rosstimo/MotorProject/README.md

# MotorProject
Super Fantastic Motor Project
