rosstimo/MotorProject/Documentation/LaTeX files/sections/MotorSpecifications.tex

\documentclass[main.tex]{subfiles}

\begin{document}

\section{Motor Manufacturer Specifications}

\subsection{RS-775126000E7 Motor}
PG27 RS775-125 Motor with Encoder

\noindent
The test motor was purchased here: \href{https://www.andymark.com/products/rs775-125-motor-with-encoder-for-pg27-gearbox}{www.andymark.com (PG27 RS775-125 Motor with Encoder)}

    \begin{figure}[h]
        %\centering  
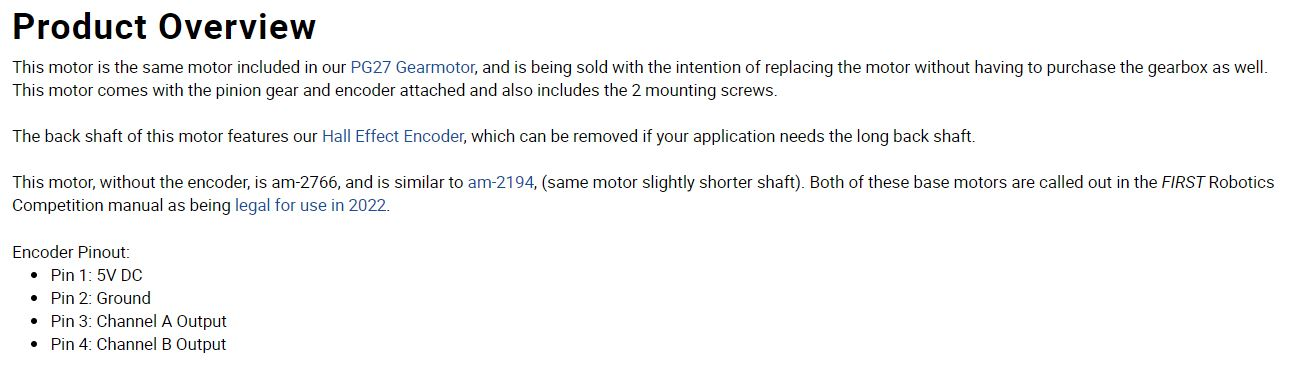
[picture p12: Documentation/LaTeX files/images/IMG_MotorRS_Overview.jpg]
        
        \vspace{0pt}
        %\caption{RS-775126000E7 Overview} %\label{Fig:BluetoothSpeaker}
    \end{figure}
\vspace{-30pt}
    \begin{figure}[h]
        %\centering  
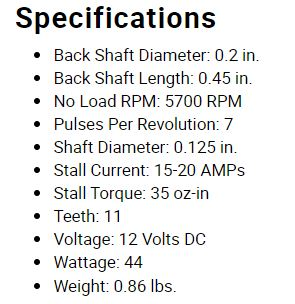
[picture p13: Documentation/LaTeX files/images/IMG_MotorRS_Specifications.jpg]
        
        \vspace{0pt}
        %\caption{RS-775126000E7 Overview} %\label{Fig:BluetoothSpeaker}
    \end{figure}

    \begin{figure}[h]
        \centering  
        
        \vspace{0pt}
        \caption{RS-775126000E7 Dimensions} %\label{Fig:BluetoothSpeaker}
    \end{figure}

    \noindent Motor dimensions pdf can be downloaded here: \href{https://cdn.andymark.com/media/W1siZiIsIjIwMjAvMDEvMDIvMTYvMzkvMzYvMjE2ZDkxMjgtMGY5OC00ZTFjLWJiNjItODU5YmVmY2I2OTcxL2FtLTMxMDkgUlM3NzUtMTI1IE1vdG9yIHdpdGggRW5jb2Rlci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}{andymark.com (layout prints PG27 RS775-125 Motor with Encoder)}

\clearpage
    \subsection{TS-25GA370H-20 Motor}
    Encoder Metal Gearmotor 12V DC High Speed 300RPM Gear Motor with Encoder for Arduino and 3D Printers\\

    \noindent The test motor was purchased here: \href{https://www.amazon.com/Bemonoc-Encoder-Gearmotor-Two-Channel-Effect/dp/B07GNGCNK1?th=1}{www.amazon.com (Encoder Metal Gearmotor 12V DC High Speed 300RPM Gear Motor with Encoder for Arduino and 3D Printers)}

    \noindent \textbf{Product type}: DC Gear motor with two-channel Hall effect encoder
    \begin{itemize}
        \item Rated Voltage: 12V
        \item No-Load Speed: 300RPM
        \item No-Load Current: $\leq$ 0.15A
        \item Rated Torque: 0.5kg.cm
        \item Single Output 240 Pulses Per Revolution
        \item Gear Reduction Ratio: 1/20
        \item Each Loop Output Pulses: 12PPR 20$\times$12=240PPR
    \end{itemize}

    %\begin{figure}[h]
    %    \centering  
    %    \includegraphics[width=0.6\textwidth]{images/IMG_MotorTS_Specifications.jpg}
    %    \vspace{0pt}
    %    \caption{TS-25GA370H-20 Motor Specifications} %\label{Fig:BluetoothSpeaker}
    %\end{figure}

    \begin{figure}[h]
        \centering  
        
        \vspace{0pt}
        \caption{TS-25GA370H-20 Wiring} %\label{Fig:BluetoothSpeaker}
    \end{figure}

    \noindent \textbf{Motor Dimensions}:
    \begin{itemize}
        \item Main Body: 66 x 25mm / 2.6in x 0.99in (L*D)
        \item Out Shaft: 11 x 4mm / 0.433 x 0.1575in (L*D) with 10 x 0.5mm / 0.39 * 0.017inches flat cut off
    \end{itemize}
    
    \begin{figure}[h]
        \centering  
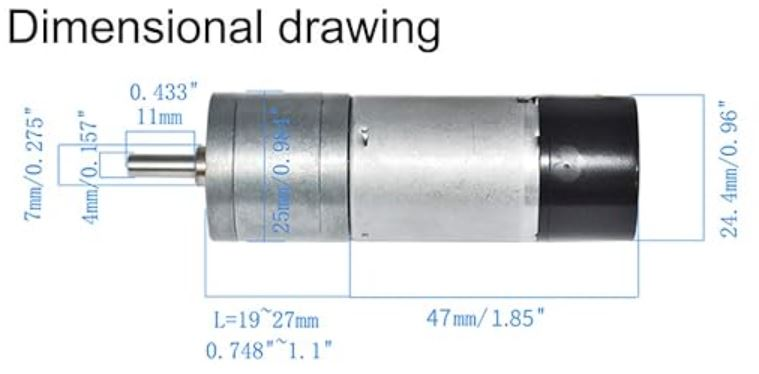
[picture p14: Documentation/LaTeX files/images/IMG_MotorTS_Dimensions.jpg]
        
        \vspace{0pt}
        \caption{TS-25GA370H-20 Dimensions} %\label{Fig:BluetoothSpeaker}
    \end{figure}

\end{document}
