rosstimo/MotorProject/Documentation/LaTeX files/main.tex

\documentclass[a4paper,10pt]{article}

\usepackage{fancyhdr}
\usepackage{graphicx}
\usepackage{float}
\usepackage{geometry}
\geometry{a4paper, left=2cm, right=2cm, top=1.5cm, bottom=3cm }
\usepackage{caption}
\usepackage{subcaption}
\captionsetup[figure]{labelfont=bf}

%% Widow/orphan control
\raggedbottom
\widowpenalty=10000
\clubpenalty=10000
\usepackage{tabularx}
\usepackage{longtable}
\usepackage{siunitx}
\usepackage{hyperref}
    \hypersetup{
        colorlinks=true,
        linkcolor={black!50!black},
        citecolor={blue!50!black},
        urlcolor=blue, %{blue!80!blue}
        }

\urlstyle{same}

\usepackage{pdfpages}

\fancypagestyle{pdfpagestyle}{
  \fancyhf{}
  \rfoot{\thepage}
  \renewcommand{\headrulewidth}{0pt}
  \renewcommand{\footrulewidth}{0pt}
}

\usepackage{natbib}
\usepackage[dvipsnames]{xcolor}
\usepackage{subfiles}

\definecolor{roarange_lt}{RGB}{246, 146, 64}
\usepackage{etoolbox,fancyhdr,xcolor}
\newcommand{\headrulecolor}[1]{\patchcmd{\headrule}{\hrule}{\color{#1}\hrule}{}{}}
\newcommand{\footrulecolor}[1]{\patchcmd{\footrule}{\hrule}{\color{#1}\hrule}{}{}}
\renewcommand{\headrulewidth}{1pt}
\headrulecolor{roarange_lt!100}%
\renewcommand{\footrulewidth}{1pt}
\footrulecolor{roarange_lt!100}%

\fancyhf{}
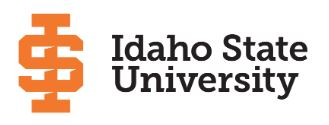
[picture p15: Documentation/LaTeX files/images/ISU_Logo.JPG]
\fancyhead[R]{}

\fancyfoot[L]{Project: PLC Lab Trainer System}
\fancyfoot[C]{College of Technology}
\fancyfoot[R]{\thepage}

\setlength{\headheight}{15mm}
\pagestyle{fancy}

\bibliographystyle{apalike}

\usepackage{times}
\begin{document}

%% ---- Cover Page ----
\begin{titlepage}
\centering

\vspace*{2cm}

\\[2cm]

{\color{roarange_lt}\rule{\textwidth}{2pt}}\\[0.6cm]

{\fontsize{28}{34}\selectfont \textbf{PLC LAB TRAINER SYSTEM}}\\[0.5cm]

{\fontsize{20}{24}\selectfont TECHNICAL MANUAL}\\[0.6cm]

{\color{roarange_lt}\rule{\textwidth}{2pt}}\\[1.2cm]

{\Large \textit{Heater Control Box \& Motor Control Box}}\\[3cm]

{\large \textbf{Authors}}\\[0.4cm]
{\large B. Anderson \quad T. Leishman \quad T. Rossiter}\\[2cm]

{\large Idaho State University}\\
{\large College of Technology}\\
{\large Pocatello, Idaho}\\[1cm]

{\large \today}

\vfill

\end{titlepage}

%% ---- Table of Contents ----
\tableofcontents
\clearpage

%% ---- Introduction / Project Overview ----
\subfile{sections/ProjectOverview}
\clearpage

%% ---- Part I: System Interfaces ----
\part{System Interfaces}
\subfile{sections/SystemArchitecture}
\clearpage

%% ---- Part II: Heater Control Box ----
\part{Heater Control Box}
\subfile{sections/HeaterBoxOverview}
\clearpage
\subfile{sections/HeaterBoxComponents}
\clearpage
\subfile{sections/HeaterBoxPLCInterface}
\clearpage

%% ---- Part III: Motor Control Box ----
\part{Motor Control Box}
\subfile{sections/Introduction}
\clearpage
\subfile{sections/MotorSpecsSummary}
\clearpage
\subfile{sections/SchematicDescription}
\clearpage
\section{Pico Encoder Documentation}
\subfile{sections/UsingQuadratureEncoderForMotorDirectionSpeedAndPosition}
\clearpage
\subfile{sections/EncoderImplementation}
\subfile{sections/EncoderFeedbackConfiguration}
\clearpage
\subfile{sections/PicoSetupGuide}

%% ---- Appendices ----
\clearpage
\appendix
\part*{Appendices}
\addcontentsline{toc}{part}{Appendices}

\section{Motor Characterization Test Data}
\label{app:motor_testing}
\subfile{sections/MotorSpecifications}
\clearpage
\subfile{sections/InitialTests}
\clearpage
\subfile{sections/EncoderTestingResults}
\clearpage

\section{Circuit Development History}
\label{app:circuit_dev}
\subfile{sections/HBridgeDevelopment}
\clearpage
\subfile{sections/TL494HBridgeDevelopment}
\clearpage

\subfile{sections/AppendixBOM}

\fontsize{8}{9}\selectfont
\bibliography{ResearchPaperBib}

\end{document}
