rosstimo/MotorProject/Documentation/LaTeX files/images/Current Design/Htr box Ain.png

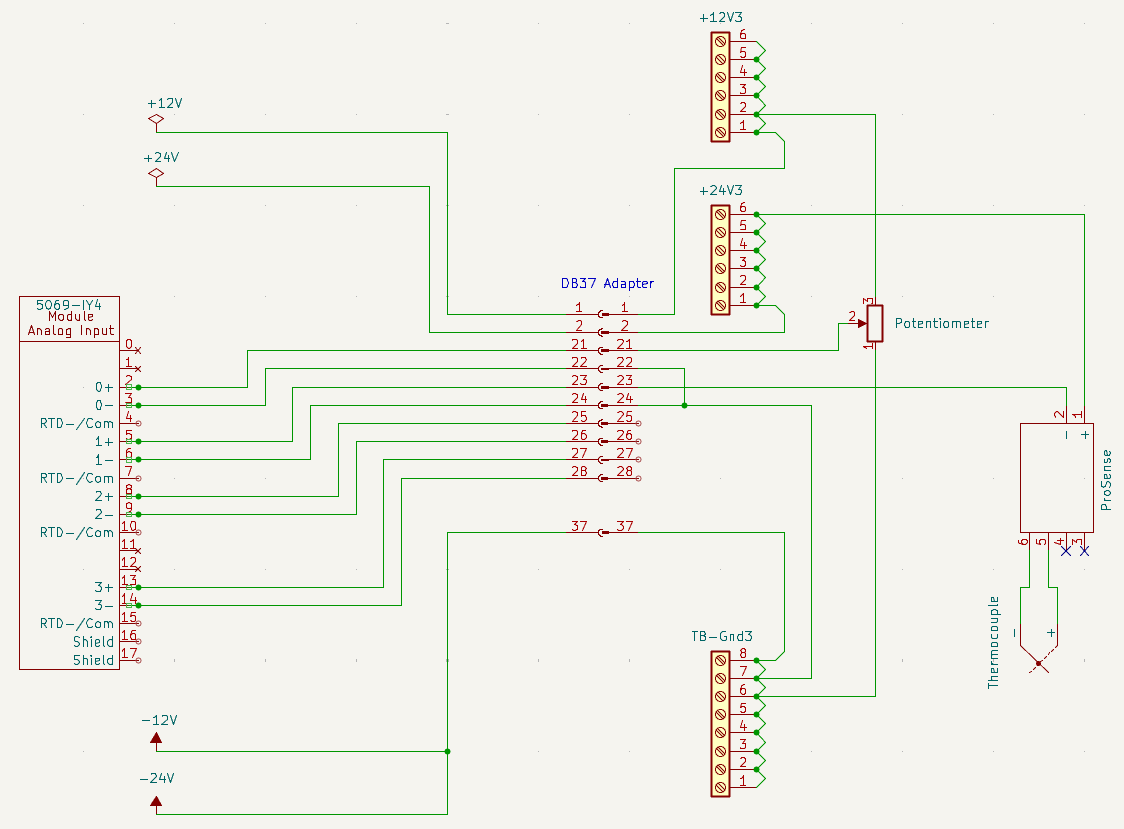
Documentation/LaTeX files/images/Current Design/Htr box Ain.png
