rosstimo/MotorProject/Documentation/LaTeX files/images/Current Design/Htr box Aout.png

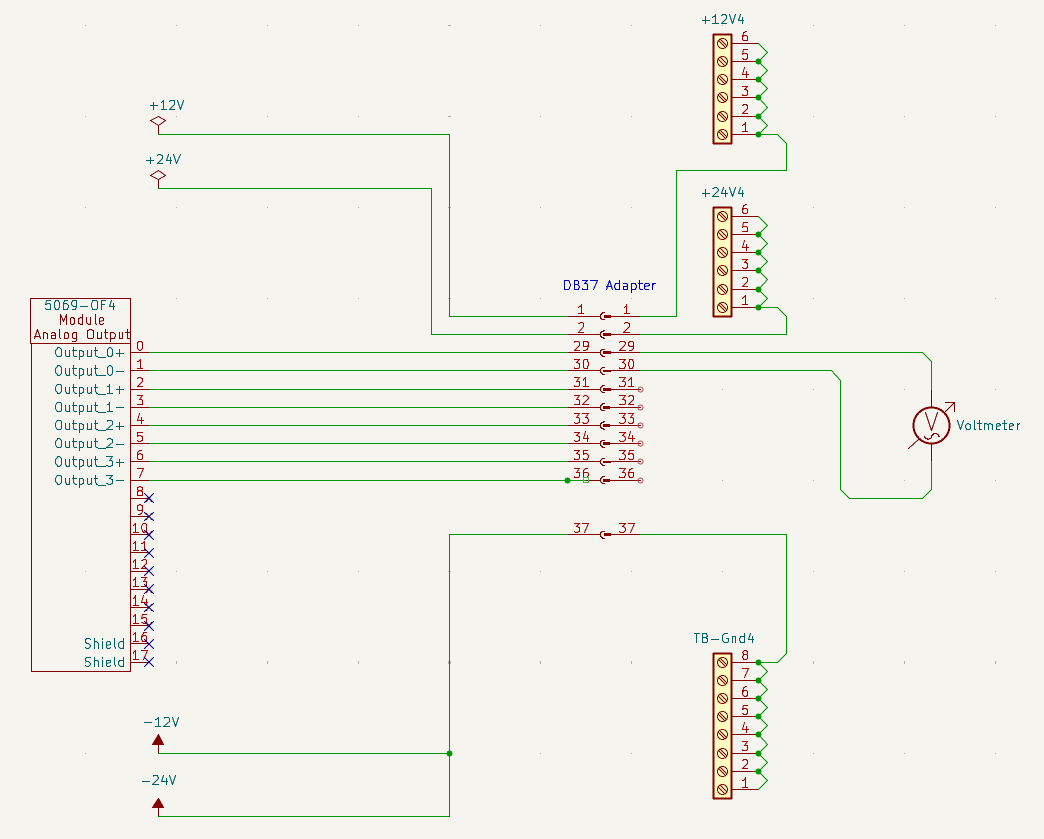
Documentation/LaTeX files/images/Current Design/Htr box Aout.png
