rosstimo/MotorProject/Documentation/LaTeX files/images/Current Design/Htr box Din.png

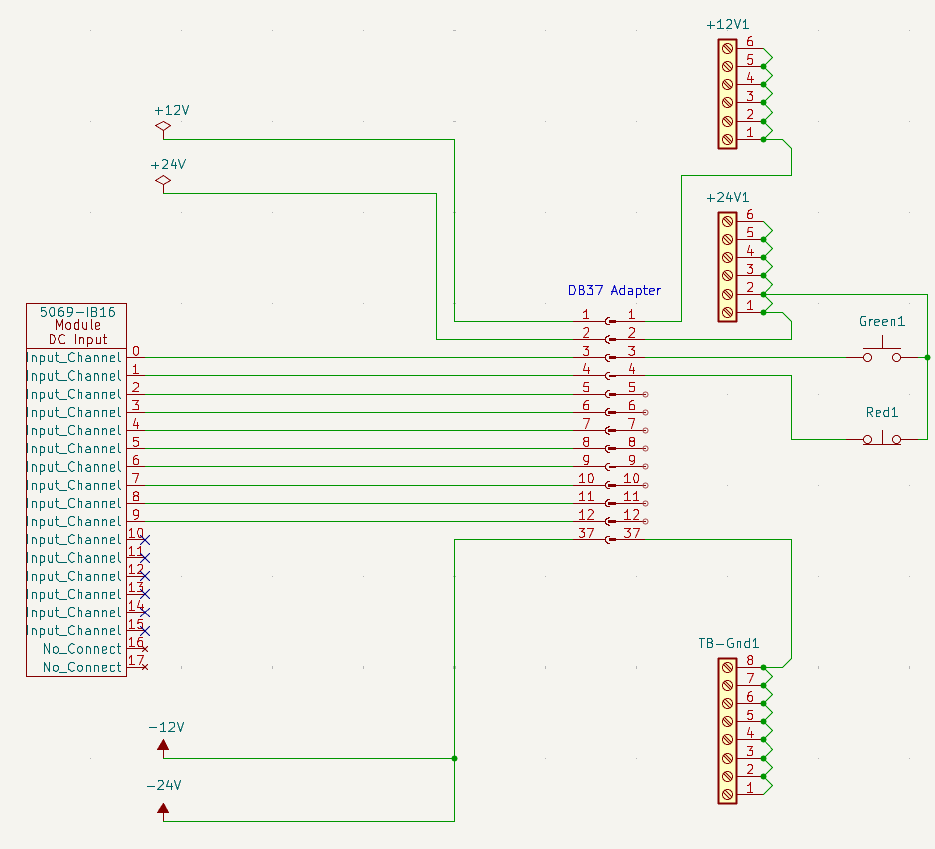
Documentation/LaTeX files/images/Current Design/Htr box Din.png
