rosstimo/MotorProject/Documentation/LaTeX files/images/Current Design/Htr box Dout.png

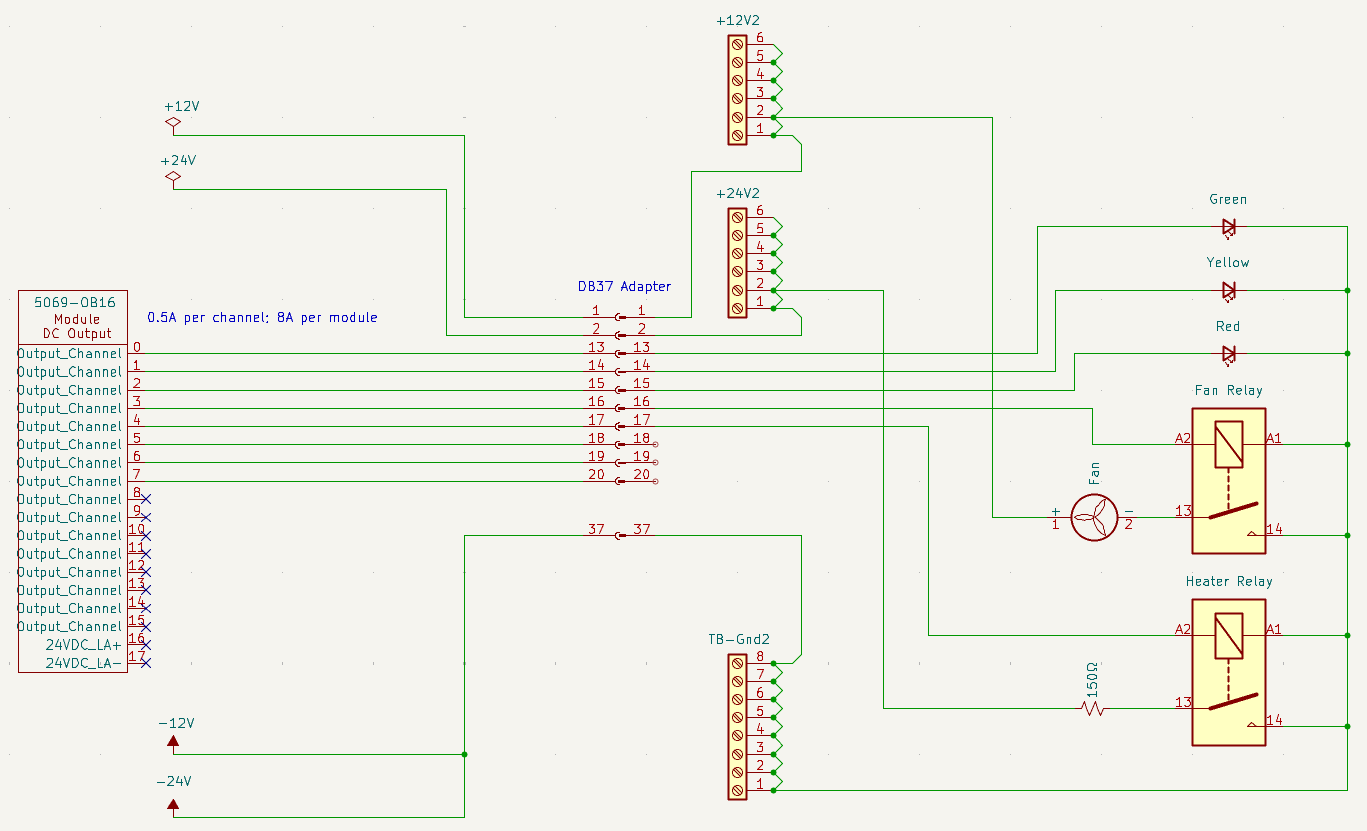
Documentation/LaTeX files/images/Current Design/Htr box Dout.png
