rosstimo/MotorProject/Documentation/LaTeX files/images/DB37 to Phoenix Contact TB.png

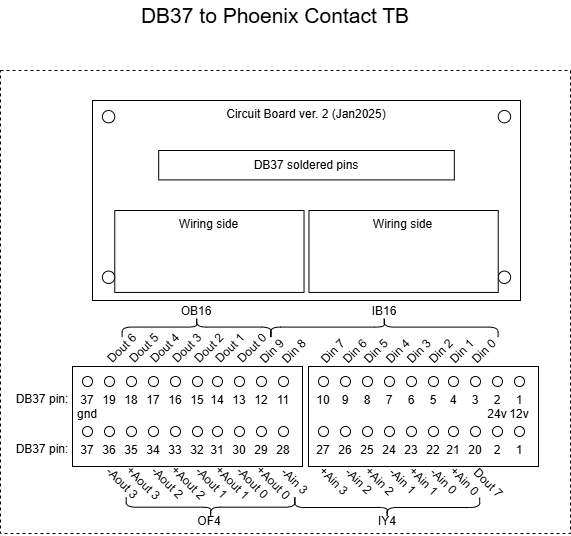
Documentation/LaTeX files/images/DB37 to Phoenix Contact TB.png
