rosstimo/MotorProject/Documentation/LaTeX files/images/Heater Box Schematic.png

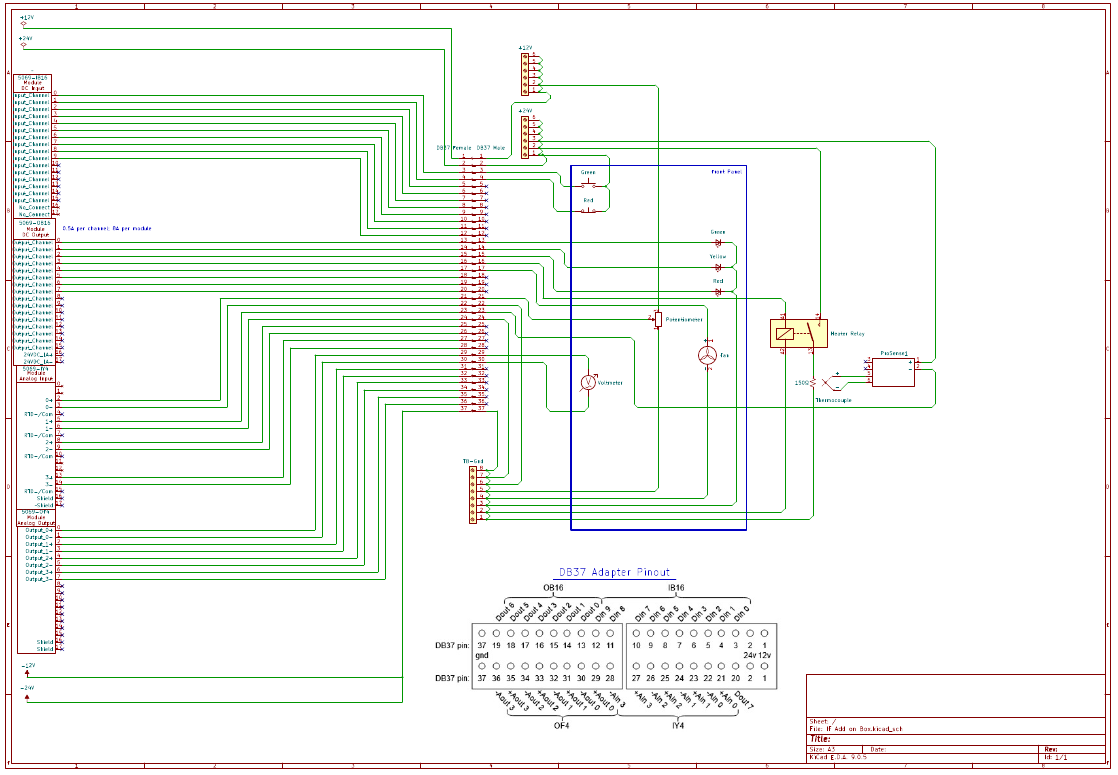
Documentation/LaTeX files/images/Heater Box Schematic.png
