rosstimo/MotorProject/Documentation/LaTeX files/images/IMG_MotorSpecificationsRS.jpg

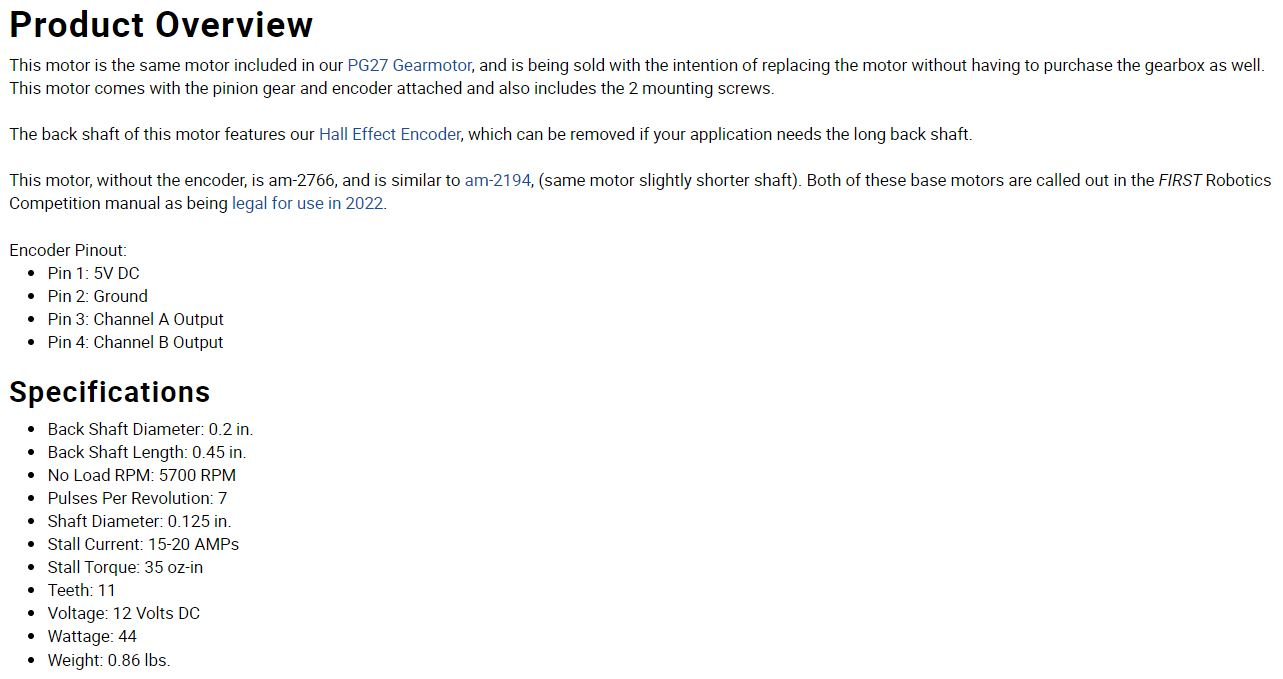
Documentation/LaTeX files/images/IMG_MotorSpecificationsRS.jpg
