rosstimo/MotorProject/Documentation/LaTeX files/images/IMG_MotorTS_Specifications.jpg

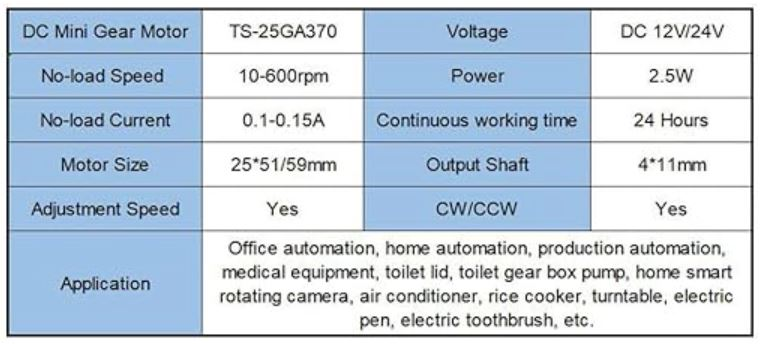
Documentation/LaTeX files/images/IMG_MotorTS_Specifications.jpg
