rosstimo/MotorProject/Mechanical/MotorDrawings/TS25GA370H_DimensionalDrawingAndSpecifications.JPG

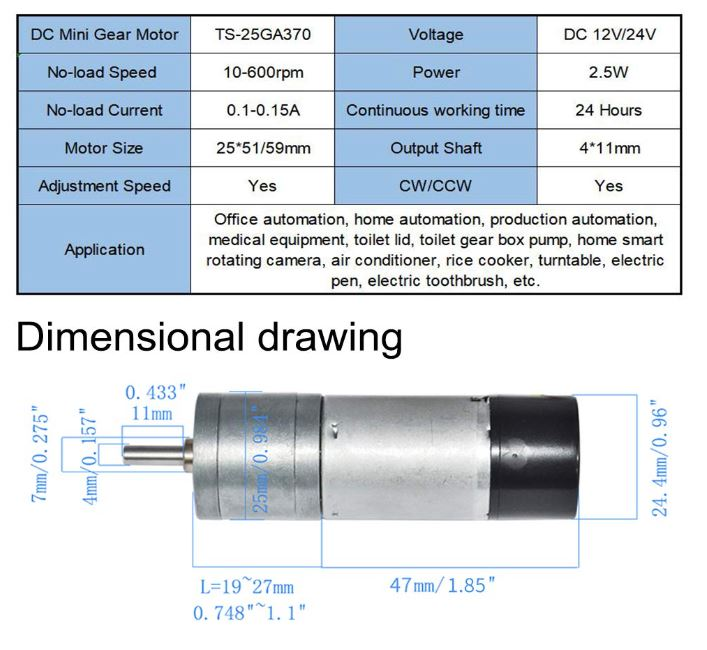
Mechanical/MotorDrawings/TS25GA370H_DimensionalDrawingAndSpecifications.JPG
