rosstimo/MotorProject/Documentation/LaTeX files/sections/AppendixBOM.tex

\documentclass[main.tex]{subfiles}

\begin{document}

\section{Bill of Materials}
\label{app:bom}

This appendix lists the BOMs for the PLC Lab Trainer System. The two trainer boxes share a common set of enclosure, cabling, and operator-interface parts (Section~\ref{sec:bom-common}); each box then adds its own subsystem-specific components (Sections~\ref{sec:bom-heater-specific} and~\ref{sec:bom-motor-specific}). Section~\ref{sec:bom-pico} lists the components on the Pico H-Bridge motor control board that mounts inside the Motor Control Box. Box-level quantities are listed per unit; the project deploys 16 of each box.

\subsection{Common Box Components}
\label{sec:bom-common}

Table~\ref{tab:bom-common} lists the components installed in both the Heater Control Box and the Motor Control Box. Each box receives one set of these parts.

\renewcommand{\arraystretch}{1.3}
\begin{longtable}{p{6.5cm} l l c}
\caption{Common Box Bill of Materials (per box, applies to both Heater and Motor boxes)} \label{tab:bom-common} \\
\hline
\textbf{Description} & \textbf{Mfg.\ Part \#} & \textbf{Source} & \textbf{Qty} \\
\hline
\endfirsthead
\hline
\textbf{Description} & \textbf{Mfg.\ Part \#} & \textbf{Source} & \textbf{Qty} \\
\hline
\endhead
\hline
\endfoot

\multicolumn{4}{l}{\textit{Enclosure and Cabling}} \\
\hline
Hinged outdoor junction box (enclosure) & ZH-121006 & PolyCase & 1 \\
DB37 male shielded cable, 1\,m & Phoenix 2926580 & Digikey & 1 \\
\hline

\multicolumn{4}{l}{\textit{Operator Interface}} \\
\hline
Potentiometer, 22\,mm panel mount, 4.7\,k\si{\ohm} & Schneider XB5AD912R4K7 & Grainger & 1 \\
Pushbutton, 22\,mm green, momentary 1NO & Dayton 30G225 & Grainger & 1 \\
Pushbutton, 22\,mm red, momentary 1NC & Dayton 30G230 & Grainger & 1 \\
Pilot light, 22\,mm green LED, 24\,V & Schneider 55WU15 & Grainger & 1 \\
Pilot light, 22\,mm yellow LED, 24\,V & Schneider 55WU17 & Grainger & 1 \\
Pilot light, 22\,mm red LED, 24\,V & Schneider 55WU16 & Grainger & 1 \\
\hline

\multicolumn{4}{l}{\textit{DB37 Passthrough Interface PCB}} \\
\hline
DB-37 male PCB-mount connector & Amphenol L717SDCH37POL2RM8C309 & Mouser & 1 \\
Terminal block, 20-position (2 rows of 10), 3.5\,mm pitch & Phoenix 1841571 (SPTD 1,5/10-H-3,5) & Mouser & 2 \\
Terminal block, 10-position (2 rows of 5), 3.5\,mm pitch & Phoenix 1841526 (SPTD 1,5/5-H-3,5) & Mouser & 1 \\

\end{longtable}
\renewcommand{\arraystretch}{1}

\subsection{Heater Box Specific Components}
\label{sec:bom-heater-specific}

Table~\ref{tab:bom-heater} lists the components unique to the Heater Control Box, in addition to the common parts in Section~\ref{sec:bom-common}. Heater element, thermocouple wire, and fan are listed as generic items because they are typically pulled from existing lab inventory rather than purchased to a specific part number.

\renewcommand{\arraystretch}{1.3}
\begin{longtable}{p{6.5cm} l l c}
\caption{Heater Control Box Specific Bill of Materials (per box)} \label{tab:bom-heater} \\
\hline
\textbf{Description} & \textbf{Mfg.\ Part \#} & \textbf{Source} & \textbf{Qty} \\
\hline
\endfirsthead
\hline
\textbf{Description} & \textbf{Mfg.\ Part \#} & \textbf{Source} & \textbf{Qty} \\
\hline
\endhead
\hline
\endfoot

\multicolumn{4}{l}{\textit{Heater and Sensing}} \\
\hline
Resistive heater element, 150\,\si{\ohm}, $\geq$\,5\,W & generic (lab inventory) & --- & 1 \\
Type-K thermocouple extension wire & generic (lab inventory) & --- & 1 \\
Universal temperature transmitter, 4--20\,mA loop output & ProSense XTD2-0-UNV-P & AutomationDirect & 1 \\
\hline

\multicolumn{4}{l}{\textit{Thermal Disturbance}} \\
\hline
Axial fan, 12\,V DC & generic (lab inventory) & --- & 1 \\
\hline

\multicolumn{4}{l}{\textit{Process Display}} \\
\hline
Analog panel voltmeter, 0--10\,V DC & Baomain 85C1 & Amazon & 1 \\
\hline

\multicolumn{4}{l}{\textit{Power Switching}} \\
\hline
General-purpose relay, DPDT, 24\,V DC coil (heater relay) & OMRON G2R-2-S-DC24(S) & Grainger & 1 \\
Relay socket, 8-pin DIN-rail / surface mount & OMRON P2RF-08-S & Grainger & 1 \\
Slim signal relay, SPDT 1NO/1NC, 6\,A 250\,VAC, 24\,V DC/AC coil, with LED indicator and DIN-rail socket base (fan relay) & Hongfa HF41F/24-ZS & Amazon & 1 \\

\end{longtable}
\renewcommand{\arraystretch}{1}

\subsection{Motor Box Specific Components}
\label{sec:bom-motor-specific}

Table~\ref{tab:bom-motor} lists the components unique to the Motor Control Box, in addition to the common parts in Section~\ref{sec:bom-common}. The Pico H-Bridge motor control board (Section~\ref{sec:bom-pico}) is mounted inside this enclosure. Motor selection varies per unit; either a gearmotor with encoder or a bare RS-775 may be installed depending on the lab exercise.

\renewcommand{\arraystretch}{1.3}
\begin{longtable}{p{6.5cm} l l c}
\caption{Motor Control Box Specific Bill of Materials (per box)} \label{tab:bom-motor} \\
\hline
\textbf{Description} & \textbf{Mfg.\ Part \#} & \textbf{Source} & \textbf{Qty} \\
\hline
\endfirsthead
\hline
\textbf{Description} & \textbf{Mfg.\ Part \#} & \textbf{Source} & \textbf{Qty} \\
\hline
\endhead
\hline
\endfoot

\multicolumn{4}{l}{\textit{Motor (one of the following per box)}} \\
\hline
DC gearmotor with quadrature encoder, 12\,V & Amazon B07GNGCNK1 & Amazon & 1 \\
PG27 RS-775-125 motor with encoder & AndyMark RS-775-125 & AndyMark & 1 \\
RS-775 DC motor (no encoder, for open-loop labs) & --- & Amazon & 1 \\
\hline

\multicolumn{4}{l}{\textit{Motor Drive}} \\
\hline
Pico H-Bridge motor control board v3 (see Section~\ref{sec:bom-pico}) & --- & In-house & 1 \\
\hline

\multicolumn{4}{l}{\textit{Motor Cabling}} \\
\hline
JST XH 6-pin connector pair, 2.54\,mm pitch, with 300\,mm 26\,AWG pigtail (gearmotor power + encoder to PCB) & JST XH 6-pin (generic) & Amazon & 1 \\
JST XH 4-pin connector pair, 2.54\,mm pitch, with 300\,mm 26\,AWG pigtail (RS-775 encoder to PCB) & JST XH 4-pin (generic) & Amazon & 1 \\

\end{longtable}
\renewcommand{\arraystretch}{1}

\subsection{Motor Control PCB (Pico H-Bridge Complete v3)}
\label{sec:bom-pico}

Table~\ref{tab:bom} lists all components on the Pico H-Bridge motor control board v3. One assembled board is installed in each Motor Control Box.

\renewcommand{\arraystretch}{1.3}
\begin{longtable}{l l l l p{4.2cm}}
\caption{Pico H-Bridge Complete v3 Bill of Materials} \label{tab:bom} \\
\hline
\textbf{Ref} & \textbf{Value} & \textbf{Footprint} & \textbf{LCSC} & \textbf{Description} \\
\hline
\endfirsthead
\hline
\textbf{Ref} & \textbf{Value} & \textbf{Footprint} & \textbf{LCSC} & \textbf{Description} \\
\hline
\endhead
\hline
\endfoot

\multicolumn{5}{l}{\textit{Integrated Circuits}} \\
\hline
U1 & Pico & Custom & --- & Raspberry Pi Pico microcontroller \\
U5 & OPA4197 & SO-14 & C2058532 & Quad precision op-amp (output buffering) \\
U6 & LM7810 & SOT-89-3 & C122848 & 10V voltage regulator \\
U7 & LM78L05 & SOT-89-3 & C347258 & 5V voltage regulator \\
U8, U9 & 74LVC1G08 & SOT-23-5 & C19829591 & Single 2-input AND gate \\
U10 & SN74LVC1G14 & SOT-23-5 & C7835 & Single Schmitt trigger inverter \\
U11 & MCP6001R & SOT-23-5 & C154973 & Rail-to-rail op-amp (speed input buffer) \\
\hline

\multicolumn{5}{l}{\textit{Transistors}} \\
\hline
Q1, Q2 & AO3400A & SOT-23 & C20917 & N-channel MOSFET (H-Bridge low side) \\
Q3, Q4 & DMP3099L-7 & SOT-23 & C155244 & P-channel MOSFET (H-Bridge high side) \\
Q5--Q8 & MMBT3904 & SOT-23 & C20526 & NPN transistor (MOSFET gate driver) \\
\hline

\multicolumn{5}{l}{\textit{Resistors (all 0805)}} \\
\hline
R1, R2 & 330$\Omega$ & 0805 & C17630 & LED current limiting (direction LEDs) \\
R3, R5 & 1.8\,k$\Omega$ & 0805 & C17398 & Encoder signal series resistor \\
R4, R6 & 3.9\,k$\Omega$ & 0805 & C17614 & PLC input series resistor (zener clamp) \\
R7, R9 & 2.7\,k$\Omega$ & 0805 & C17530 & H-Bridge gate resistor \\
R8, R26, R27, R31, R33, R34 & 22\,k$\Omega$ & 0805 & C17560 & Voltage divider / pull-down \\
R10, R32 & 82\,k$\Omega$ & 0805 & C17840 & PLC input voltage divider (high side) \\
R11, R17 & 5.1\,k$\Omega$ & 0805 & C27834 & Output buffer filter resistor \\
R12, R13, R15, R16, R18, R19, R28, R35 & 10\,k$\Omega$ & 0805 & C17414 & Op-amp gain / bias resistor \\
R14 & 47\,k$\Omega$ & 0805 & C17713 & Speed output filter resistor \\
R20, R21 & 3.3\,k$\Omega$ & 0805 & C26010 & Encoder signal pull-down (voltage divider) \\
R22, R29 & 150$\Omega$ & 0805 & C17471 & H-Bridge gate pull-up \\
R23, R30 & 1\,k$\Omega$ & 0805 & C17513 & H-Bridge gate pull-up \\
R24 & 6.2\,k$\Omega$ & 0805 & C17767 & Speed input divider (low side) \\
R25 & 13\,k$\Omega$ & 0805 & C17455 & Speed input divider (high side) \\
\hline

\multicolumn{5}{l}{\textit{Capacitors}} \\
\hline
C1, C2, C3 & 1\,$\mu$F & 1206 & C2167419 & Output buffer integration capacitor \\
C4, C8, C12 & 100\,$\mu$F & 1210 & C23742 & Bulk decoupling (power rails) \\
C5 & 680\,pF & 0603 & C1630 & H-Bridge snubber capacitor \\
\hline

\multicolumn{5}{l}{\textit{Diodes and LEDs}} \\
\hline
D1 & LED (red) & 0805 & C84256 & Forward direction indicator \\
D2, D8, D9 & LED (white) & 0603/0805 & C2290 & Reverse direction / flyback indicator \\
D3, D4 & LED (yellow) & 0603 & C2286 & H-Bridge active direction indicator \\
D5 & Diode & SMA & C8678 & Reverse polarity protection (power input) \\
D6, D7 & 3.3V Zener & SOD-323 & C19077437 & PLC input voltage clamp (GPIO protection) \\
\hline

\multicolumn{5}{l}{\textit{Connectors and Mechanical}} \\
\hline
J1 & Screw Terminal & Phoenix 10-pos & --- & PLC interface (power, I/O, feedback) \\
J2 & JST XH 6-pin & JST XH B6B & --- & Motor encoder connector \\
J3 & Screw Terminal & Phoenix 2-pos & --- & Motor power connector \\
J4 & 2.54\,mm Header & 1$\times$2 pin & --- & Motor connection header \\
RV1 & 10\,k$\Omega$ pot & Bourns 3314J & C36376 & Speed calibration potentiometer \\
SW1 & DIP Switch & 1-pos DIP & C600988 & Motor type selection switch \\
\hline

\multicolumn{5}{l}{\textit{Test Points}} \\
\hline
TP1 & Spd & Plated hole & --- & Speed command test point \\
TP2 & 10V & Plated hole & --- & 10V rail test point \\
TP3 & 5V & Plated hole & --- & 5V rail test point \\
TP6 & GND & Loop & --- & Ground test point \\

\end{longtable}
\renewcommand{\arraystretch}{1}

\end{document}
