rosstimo/MotorProject/PCB/MotorController Part list 2024-05-24.xlsx

Index | Quantity | Part Number | Manufacturer Part Number | Description | Customer Reference | Available | Backorder | Unit Price | Extended Price USD
1 | 20 | TB67H450FNGELCT-ND | TB67H450FNG,EL | 3A/50V 1CH BRUSHED |  | 20 | 0 | 1.359 | 27.18
2 | 20 | IRF9530NPBF-ND | IRF9530NPBF | MOSFET P-CH 100V 14A TO220AB |  | 20 | 0 | 0.93 | 18.60
3 | 20 | IRF530NPBF-ND | IRF530NPBF | MOSFET N-CH 100V 17A TO220AB |  | 20 | 0 | 0.91 | 18.20
4 | 25 | 160-1370-5-ND | LTV-847 | OPTOISOLTR 5KV 4CH TRANS 16-DIP |  | 25 | 0 | 0.6312 | 15.78
5 | 10 | TC74HC14APF-ND | TC74HC14APF | IC INVERT SCHMITT 6CH 1INP 14DIP |  | 10 | 0 | 0.359 | 3.59
6 | 10 | 296-4318-5-ND | SN74AC32N | IC GATE OR 4CH 2-INP 14DIP |  | 10 | 0 | 0.537 | 5.37
7 | 40 | 160-1712-ND | LTL-4231 | LED GREEN DIFFUSED T-1 T/H |  | 40 | 0 | 0.195 | 7.80
8 | 50 | CF12JT330RCT-ND | CF12JT330R | RES 330 OHM 5% 1/2W AXIAL |  | 50 | 0 | 0.0388 | 1.94
9 | 50 | CF12JT470RCT-ND | CF12JT470R | RES 470 OHM 5% 1/2W AXIAL |  | 50 | 0 | 0.0388 | 1.94
10 | 50 | CF12JT820RCT-ND | CF12JT820R | RES 820 OHM 5% 1/2W AXIAL |  | 50 | 0 | 0.0388 | 1.94
11 | 10 | 478-8779-1-ND | TAP474K035CRW | CAP TANT 0.47UF 10% 35V RADIAL |  | 10 | 0 | 0.444 | 4.44
12 | 40 | 1727-4752-1-ND | NZX5V1A,133 | DIODE ZENER 5.1V 500MW ALF2 |  | 40 | 0 | 0.142 | 5.68
13 | 25 | 36-4955-ND | 4955 | PC TEST POINT LOOP |  | 25 | 0 | 0.166 | 4.15
14 | 10 | 732-61300811821-ND | 61300811821 | WR-PHD 2.54 MM SOCKET HEADER; 8 |  | 10 | 0 | 0.39 | 3.90
15 | 10 | 2057-ICS-316-T-ND | ICS-316-T | IC SOCKET, DIP, 16P 2.54MM PITCH |  | 10 | 0 | 0.153 | 1.53
16 | 20 | 2057-ICS-314-T-ND | ICS-314-T | IC SOCKET, DIP, 14P 2.54MM PITCH |  | 20 | 0 | 0.138 | 2.76
17 | 40 | AE10901-ND | V6560W | HEATSINK ALUM ANOD |  | 40 | 0 | 0.50075 | 20.03
18 | 5 | 2648-SC0917-ND | SC0917 | RASPBERRY PI PICO H RP2040 |  | 5 | 0 | 5 | 25.00
19 | 500 | 2019-CF1/4CT52R151JCT-ND | CF1/4CT52R151J | RES 150 OHM 5% 1/4W AXIAL |  | 500 | 0 | 0.02192 | 10.96
