rosstimo/MotorProject/PCB/MotorInterfacePiPico/BOM.csv

Item,Qty,Reference(s),Value,LibPart,Footprint,Datasheet,DNP,Cost (ea.),Datasheet,Description,Footprint,Notes,Vender Part Number,Vendor url,digikey
1,3,+ACI-C1, C2, C3+ACI-,1uF,Device:C,TJR:C+AF8-Rect+AF8-L7.3mm+AF8-W4.5+AF8-H9.5mm+AF8-P5.0mmx,https://product.tdk.com/en/system/files capacitor,TJR:C+AF8-Rect+AF8-L7.3mm+AF8-W4.5+AF8-H9.5mm+AF8-P5.0mmx,,,,https://www.digikey.com/en/products/detail/epcos+AC0-tdk+AC0-electronics/B32529C0105K189/1089751
4,8,+ACI-C4, C5, C6, C10, C11, C12, C16, C18+ACI-,100uF,TJR:C+AF8-Polarized+AF8-US,TJR:C+AF8-Radial+AF8-D5.00mm+AF8-H12.5mm+AF8-P2.00mm,https://www.rubycon.co.jp/wp+AC0-content/uploads/catalog+AC0-aluminum/ZLH.pdf,,,https://www.rubycon.co.jp/wp+AC0-content/uploads/catalog+AC0-aluminum/ZLH.pdf,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 capacitor,TJR:C+AF8-Radial+AF8-D5.00mm+AF8-H12.5mm+AF8-P2.00mm,,,,https://www.digikey.com/en/products/detail/rubycon/16ZLH100MEFC5X11/3134106
6,8,+ACI-C7, C8, C9, C13, C14, C15, C17, C19+ACI-,0.1uF,:C+AF8-3,TJR:C+AF8-Rect+AF8-L7.3mm+AF8-W2.5+AF8-H6.5mm+AF8-P5.0mm,https://product.tdk.com/en/system/files capacitor,TJR:C+AF8-Rect+AF8-L7.3mm+AF8-W2.5+AF8-H6.5mm+AF8-P5.0mm,,,,https://www.digikey.com/en/products/detail/epcos+AC0-tdk+AC0-electronics/B32529C0104K189/1089746
13,2,+ACI-D1, D2+ACI-,LED,00TJR:LED,TSL:LED+AF8-D3.0mm,+AH4-,,,+AH4-,Light emitting diode,TSL:LED+AF8-D3.0mm,,,,
14,1,J1,Motor Connector,Connector:Conn+AF8-01x06+AF8-Pin,Connector+AF8-JST:JST+AF8-XH+AF8-B6B+AC0-XH+AC0-A+AF8-1x06+AF8-P2.50mm+AF8-Vertical,+AH4-,,,+AH4-,+ACI-Generic connector, single row, 01x06, script generated+ACI-,Connector+AF8-JST:JST+AF8-XH+AF8-B6B+AC0-XH+AC0-A+AF8-1x06+AF8-P2.50mm+AF8-Vertical,,,,
15,1,J2,Screw+AF8-Terminal+AF8-01x06,Connector:Screw+AF8-Terminal+AF8-01x06,+ACI-TerminalBlock+AF8-Phoenix:TerminalBlock+AF8-Phoenix+AF8-PT+AC0-1,5+AC0-6+AC0-5.0+AC0-H+AF8-1x06+AF8-P5.00mm+AF8-Horizontal+ACI-,+AH4-,,,+AH4-,+ACI-Generic screw terminal, single row, 01x06, script generated (kicad+AC0-library+AC0-utils/schlib/autogen/connector/)+ACI-,+ACI-TerminalBlock+AF8-Phoenix:TerminalBlock+AF8-Phoenix+AF8-PT+AC0-1,5+AC0-6+AC0-5.0+AC0-H+AF8-1x06+AF8-P5.00mm+AF8-Horizontal+ACI-,,,,
16,3,+ACI-Q1, Q2, Q3+ACI-,2N3904,TJR:2N3904,TJR:TO+AC0-92+AC0-3+AF8-Formed+AF8-Leads,https://www.fairchildsemi.com/datasheets/2N/2N3904.pdf,,,https://www.fairchildsemi.com/datasheets/2N/2N3904.pdf,+ACI-0.2A Ic, 40V Vce, Small Signal NPN Transistor, TO+AC0-92+ACI-,TJR:TO+AC0-92+AC0-3+AF8-Formed+AF8-Leads,,,,
17,12,+ACI-R1, R2, R3, R4, R7, R8, R9, R10, R11, R12, R13, R17+ACI-,10k,TJR:R,TJR:R+AF8-Axial+AF8-DIN0207+AF8-L6.3mm+AF8-D2.5mm+AF8-P7.62mm+AF8-Horizontal,https://www.seielect.com/catalog/sei+AC0-cf+AF8-cfm.pdf,,,https://www.seielect.com/catalog/sei+AC0-cf+AF8-cfm.pdf,1/2W,TJR:R+AF8-Axial+AF8-DIN0207+AF8-L6.3mm+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
18,2,+ACI-R5, R6+ACI-,330,TJR:R,TJR:R+AF8-Axial+AF8-DIN0207+AF8-L6.3mm+AF8-D2.5mm+AF8-P7.62mm+AF8-Horizontal,https://www.seielect.com/catalog/sei+AC0-cf+AF8-cfm.pdf,,,https://www.seielect.com/catalog/sei+AC0-cf+AF8-cfm.pdf,1/2W,TJR:R+AF8-Axial+AF8-DIN0207+AF8-L6.3mm+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
19,2,+ACI-R14, R16+ACI-,5.1k,TJR:R,TJR:R+AF8-Axial+AF8-DIN0207+AF8-L6.3mm+AF8-D2.5mm+AF8-P7.62mm+AF8-Horizontal,https://www.seielect.com/catalog/sei+AC0-cf+AF8-cfm.pdf,,,https://www.seielect.com/catalog/sei+AC0-cf+AF8-cfm.pdf,1/2W,TJR:R+AF8-Axial+AF8-DIN0207+AF8-L6.3mm+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
20,1,R15,47k,TJR:R,TJR:R+AF8-Axial+AF8-DIN0207+AF8-L6.3mm+AF8-D2.5mm+AF8-P7.62mm+AF8-Horizontal,https://www.seielect.com/catalog/sei+AC0-cf+AF8-cfm.pdf,,,https://www.seielect.com/catalog/sei+AC0-cf+AF8-cfm.pdf,1/2W,TJR:R+AF8-Axial+AF8-DIN0207+AF8-L6.3mm+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
21,1,U1,Pico,MCU+AF8-RaspberryPi+AF8-and+AF8-Boards:Pico,TJR:RPi+AF8-Pico+AF8-SMD+AF8-TH,,,,,,TJR:RPi+AF8-Pico+AF8-SMD+AF8-TH,,,,https://www.digikey.com/en/products/detail/texas+AC0-instruments/LM2940T+AC0-10+AC0-0+AC0-NOPB/148141
22,1,U2,OPA4197,Amplifier+AF8-Operational:OPA4197xPW,TJR:D14+AF8-TEX,http://www.ti.com/lit/ds/symlink/opa4197.pdf,,,http://www.ti.com/lit/ds/symlink/opa4197.pdf,+ACI-Quad 36V, Precision, Rail+AC0-to+AC0-Rail Input/Output, Low Offset Voltage, Operational Amplifier, TSSOP+AC0-14+ACI-,TJR:D14+AF8-TEX,+ACI-14+AC0-SOIC (0.154+ACIAIg-, 3.90mm Width)+ACI-,,,https://www.digikey.com/en/products/detail/texas+AC0-instruments/OPA4197ID/6562050
23,1,U3,LM7810,Regulator+AF8-Linear:LM7810+AF8-TO220,Package+AF8-TO+AF8-SOT+AF8-THT:TO+AC0-220+AC0-3+AF8-Vertical,https://www.ti.com/lit/ds/symlink/lm2940+AC0-n.pdf 1A 35V Linear Regulator, Fixed Output 10V, TO+AC0-220+ACI-,Package+AF8-TO+AF8-SOT+AF8-THT:TO+AC0-220+AC0-3+AF8-Vertical,LM7810 obsolete,,,https://www.digikey.com/en/products/detail/texas+AC0-instruments/LM2940T+AC0-10+AC0-0+AC0-NOPB/148141
24,1,U4,LM78L05,Regulator+AF8-Linear:LM78L05+AF8-TO92,Package+AF8-TO+AF8-SOT+AF8-THT:TO+AC0-92+AF8-Inline,https://www.ti.com/general/docs/suppproductinfo.tsp 100mA 30V Linear Regulator, Fixed Output 5V, TO+AC0-92+ACI-,Package+AF8-TO+AF8-SOT+AF8-THT:TO+AC0-92+AF8-Inline,,,,https://www.digikey.com/en/products/detail/texas+AC0-instruments/LM78L05ACZ+AC0-NOPB/6333
