rosstimo/MotorProject/Mechanical/LaserTableFiles/SVGFilesMotorMount/KeyPad.3mf

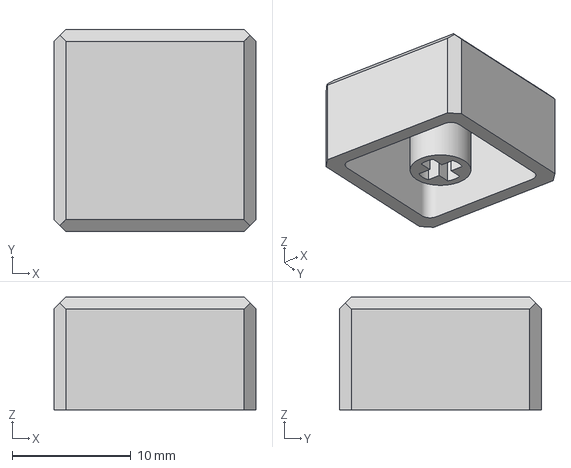
[picture p50: CAD file, 2025-05-12]
Mechanical/LaserTableFiles/SVGFilesMotorMount/KeyPad.3mf
17.0 x 17.0 x 9.50 mm
