rosstimo/MotorProject/Mechanical/MotorCoupler/MotorCoupler.3mf

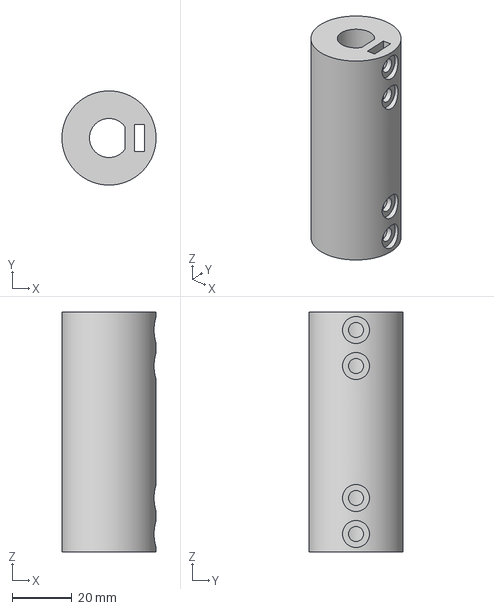
[picture p51: CAD file, 2025-05-12]
Mechanical/MotorCoupler/MotorCoupler.3mf
31.4 x 31.4 x 80.0 mm
