rosstimo/MotorProject/Mechanical/StopLightProject/3dPrintFiles/db37Bracket.stl

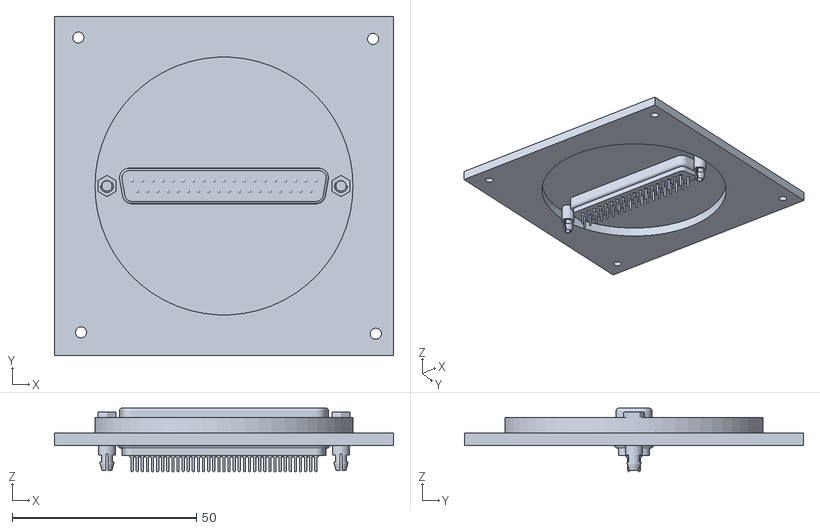
[picture p52: CAD file, 2025-07-14]
Mechanical/StopLightProject/3dPrintFiles/db37Bracket.stl
92.0 x 92.0 x 17.3
