rosstimo/MotorProject/Mechanical/StopLightProject/3dPrintFiles/RPI Box Plate.stl

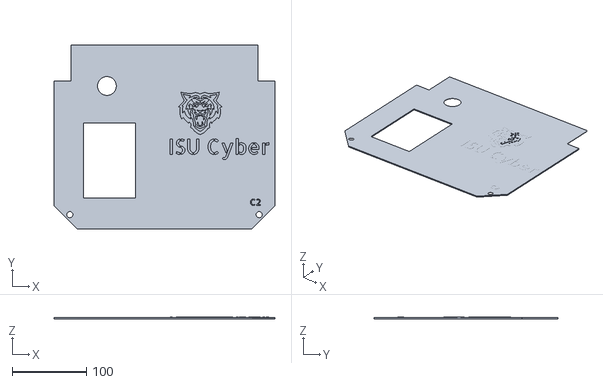
[picture p53: CAD file, 2025-07-14]
Mechanical/StopLightProject/3dPrintFiles/RPI Box Plate.stl
298.4 x 247.8 x 2.10
