rosstimo/MotorProject/Mechanical/StopLightProject/3dPrintFiles/Center.3mf

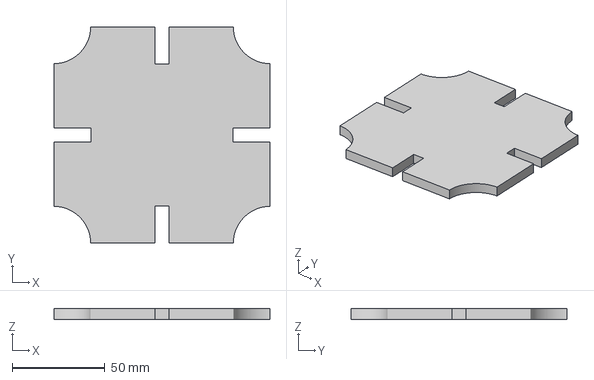
[picture p54: CAD file, 2025-05-12]
Mechanical/StopLightProject/3dPrintFiles/Center.3mf
116.6 x 116.6 x 6.00 mm
