rosstimo/MotorProject/Mechanical/StopLightProject/3dPrintFiles/StopLightMountingHolesAdjusted.3mf

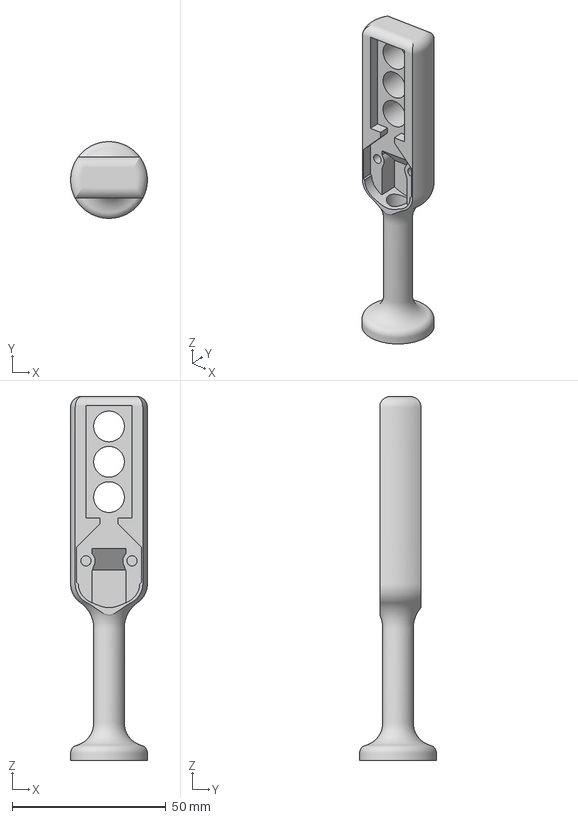
[picture p55: CAD file, 2025-05-12]
Mechanical/StopLightProject/3dPrintFiles/StopLightMountingHolesAdjusted.3mf
25.0 x 25.0 x 118.5 mm
