rosstimo/MotorProject/Mechanical/StopLightProject/3dPrintFiles/Lane.3mf

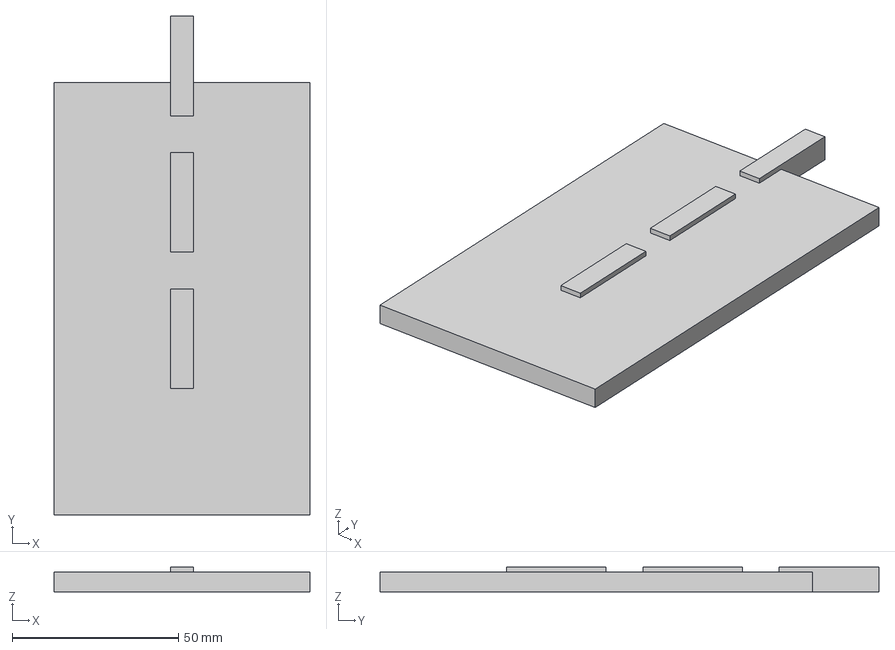
[picture p56: CAD file, 2025-05-12]
Mechanical/StopLightProject/3dPrintFiles/Lane.3mf
77.0 x 150.0 x 7.50 mm
