rosstimo/MotorProject/Mechanical/StopLightProject/OLD/StopLight3.3mf

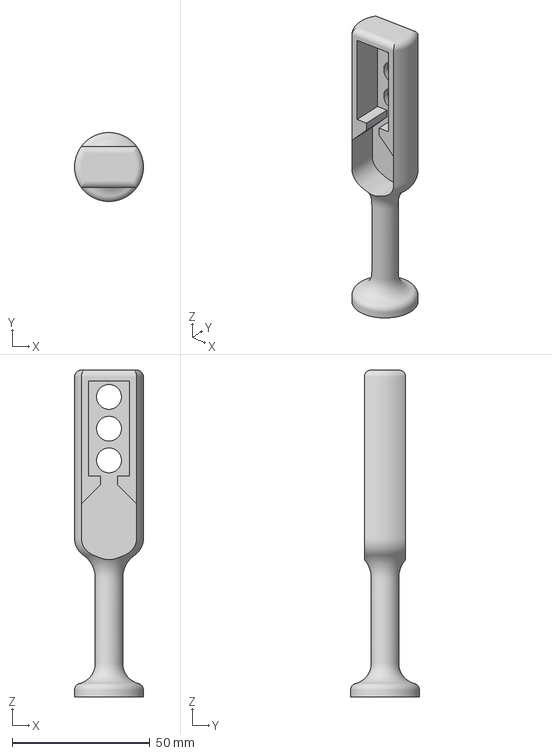
[picture p57: CAD file, 2025-05-12, an earlier design]
Mechanical/StopLightProject/OLD/StopLight3.3mf
25.0 x 25.0 x 118.5 mm
