rosstimo/MotorProject/Mechanical/StopLightProject/OLD/Traffic_Intersection.3mf

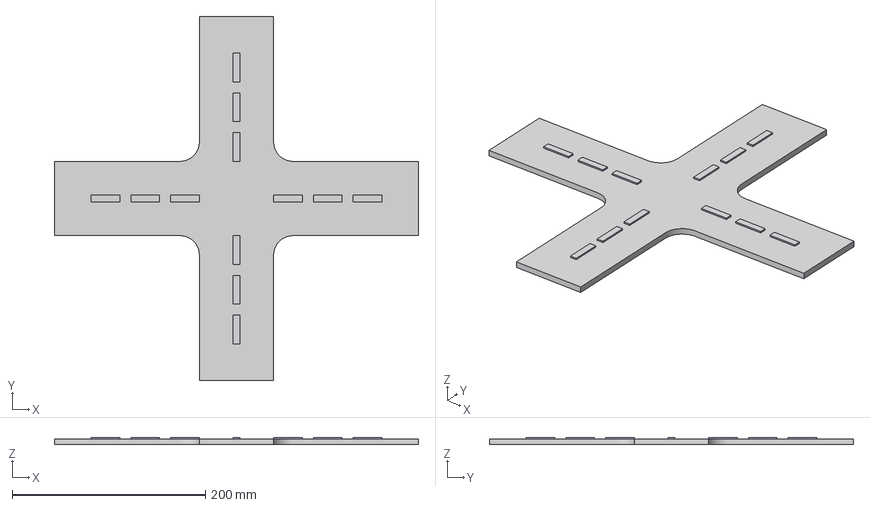
[picture p58: CAD file, 2025-05-12, an earlier design]
Mechanical/StopLightProject/OLD/Traffic_Intersection.3mf
377.0 x 377.0 x 7.50 mm
