rosstimo/MotorProject/Mechanical/StopLightProject/OLD/Traffic_Intersection2.3mf

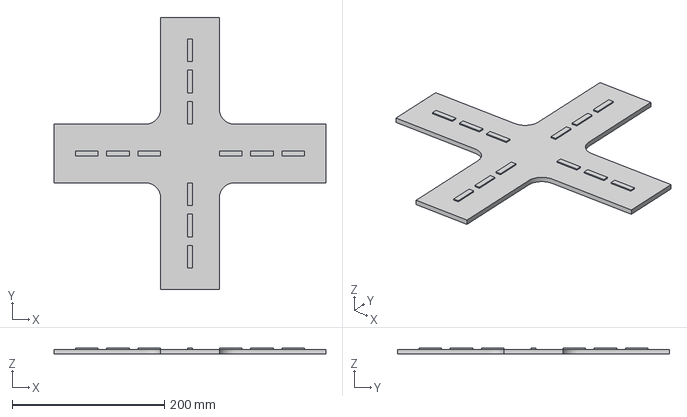
[picture p59: CAD file, 2025-05-12, an earlier design]
Mechanical/StopLightProject/OLD/Traffic_Intersection2.3mf
357.0 x 357.0 x 7.50 mm
