rosstimo/MotorProject/(list of files, cad)

Other CAD files:
Mechanical/LaserTableFiles/SVGFilesMotorMount/Body1.3mf
Mechanical/StopLightProject/OLD/StopLight.3mf
Mechanical/StopLightProject/OLD/Stop_Light.3mf
