rosstimo/MotorProject/Mechanical/MotorDrawings/am-3109 RS775-125 Motor Drawings.pdf

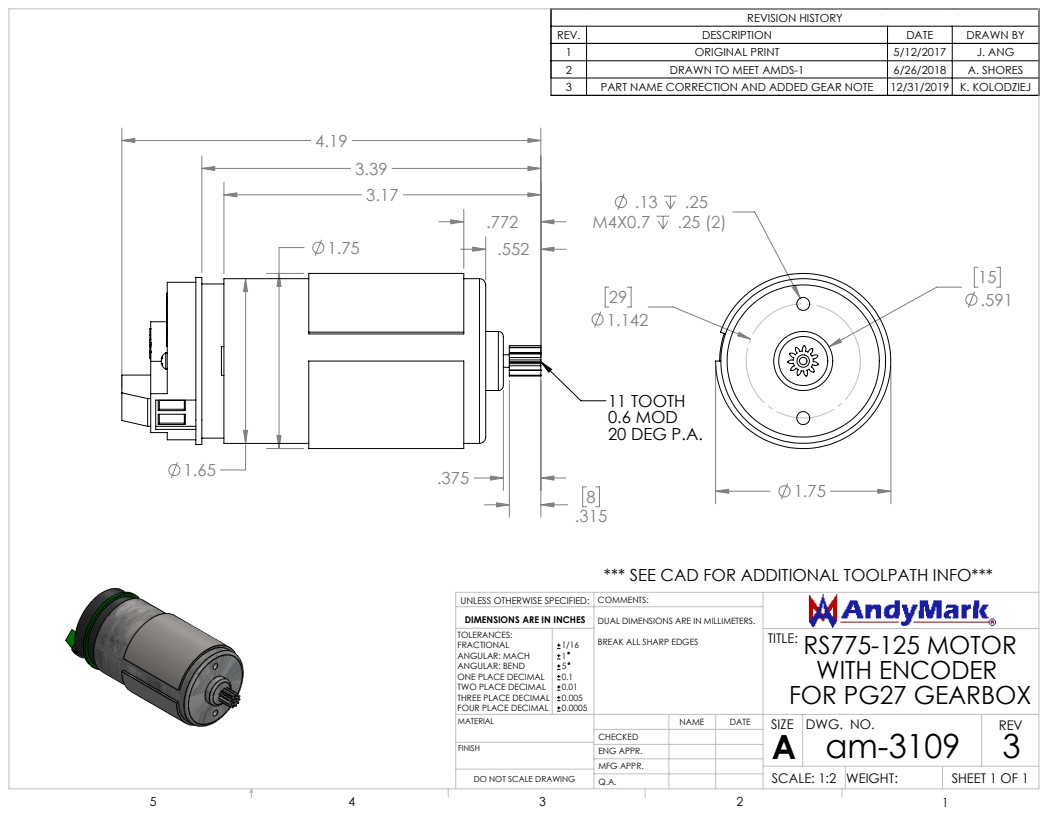
[picture p62: page 1]
11 TOOTH 0.6 MOD 20 DEG P.A.; REVISION HISTORY; RS775-125 MOTOR WITH ENCODER FOR PG27 GEARBOX; SHEET 1 OF 1; SCALE: 1:2 WEIGHT:; DWG. NO.; REV; MFG APPR.; ENG APPR.

REV. | DESCRIPTION | DATE | DRAWN BY
1 | ORIGINAL PRINT | 5/12/2017 | J. ANG
2 | DRAWN TO MEET AMDS-1 | 6/26/2018 | A. SHORES
3 | PART NAME CORRECTION AND ADDED GEAR NOTE | 12/31/2019 | K. KOLODZIEJ

*** SEE CAD FOR ADDITIONAL TOOLPATH INFO***

UNLESS OTHERWISE SPECIFIED:
DIMENSIONS ARE IN INCHES
TOLERANCES:
FRACTIONAL
ANGULAR: MACH
ANGULAR: BEND
ONE PLACE DECIMAL
TWO PLACE DECIMAL
THREE PLACE DECIMAL
FOUR PLACE DECIMAL
MATERIAL

COMMENTS:
DUAL DIMENSIONS ARE IN MILLIMETERS.
BREAK ALL SHARP EDGES

DO NOT SCALE DRAWING
