rosstimo/MotorProject/PCB/MotorInterfaceDiscrete/MotorInterface.pdf

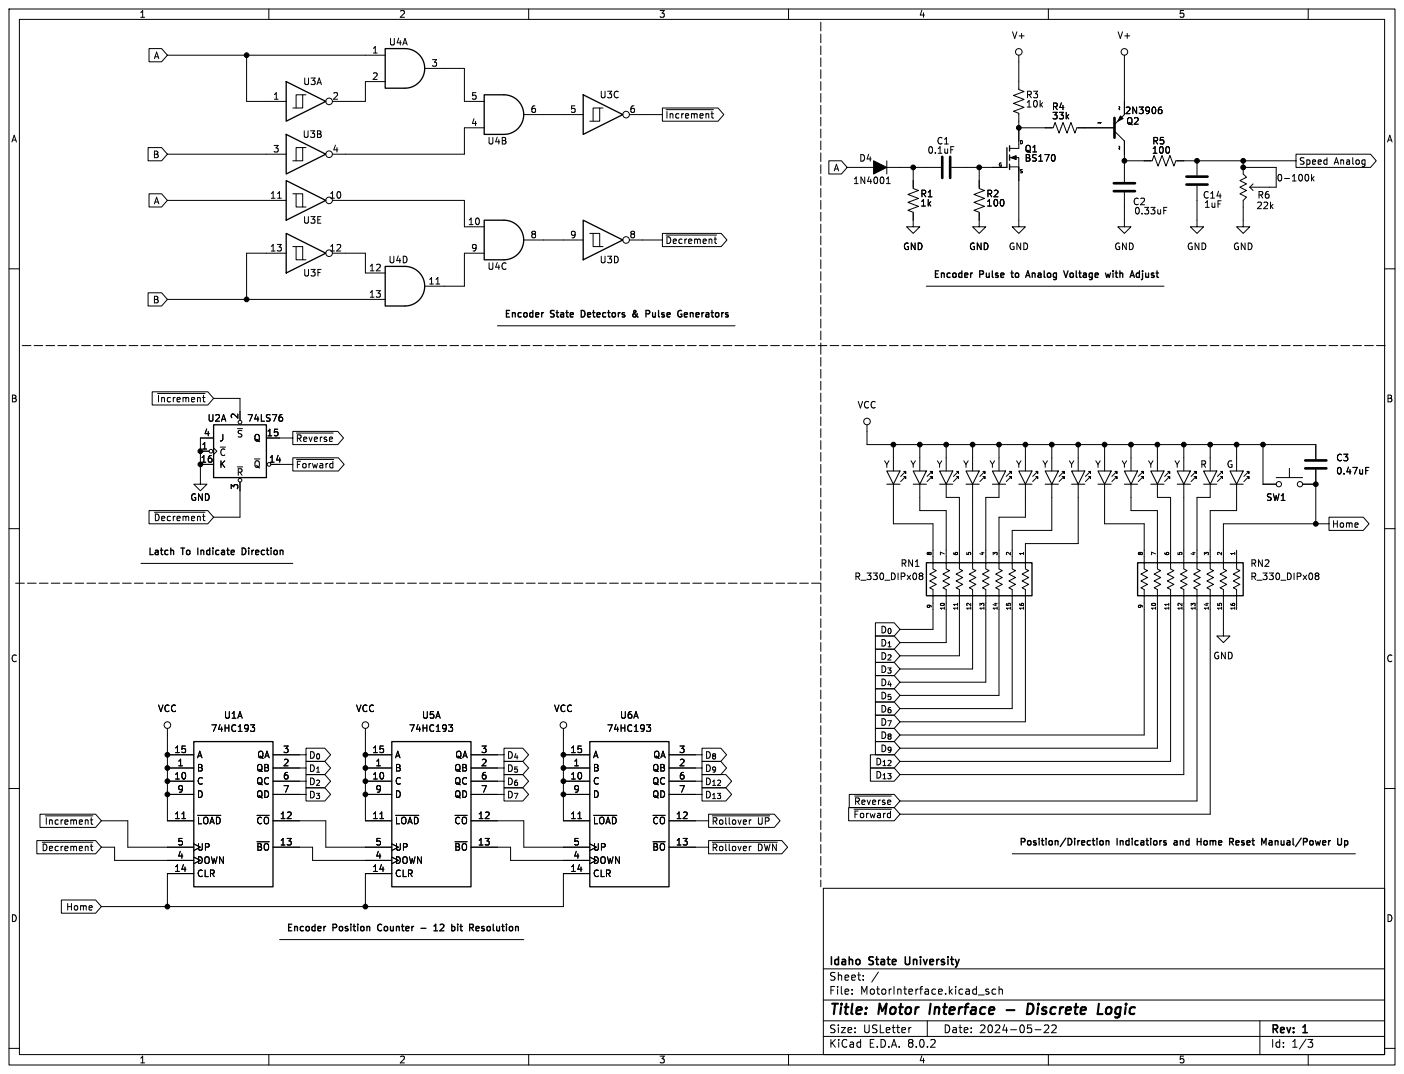
[picture p63: page 1]

Latch To Indicate DirectionEncoder Position Counter - 12 bit Resolution

Id: 1/3 Title: Motor Interface - Discrete Logic

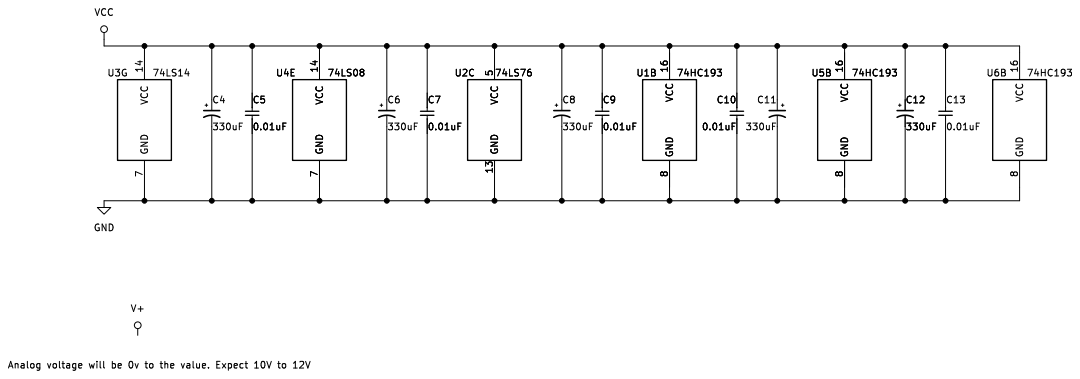
[picture p64: page 2]

Id: 2/3 Title: Motor Interface - Discrete Logic

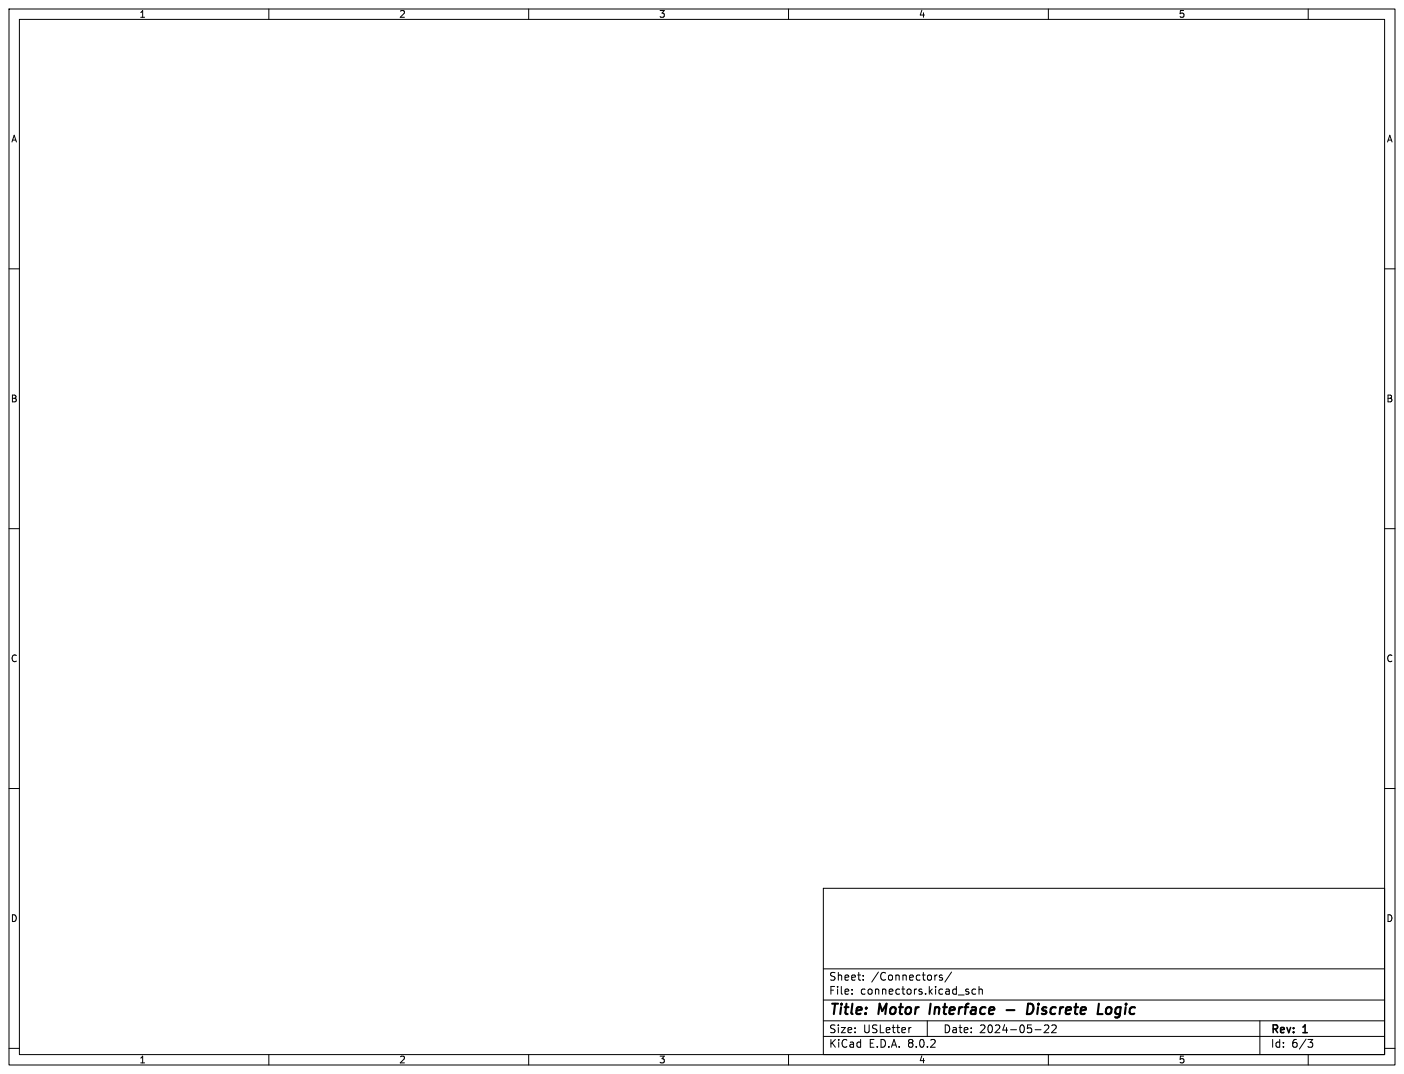
[picture p65: page 3]

File: connectors.kicad_sch Sheet: /Connectors/
Id: 6/3 Title: Motor Interface - Discrete Logic
