rosstimo/MotorProject/Documentation/LaTeX files/images/DB37 to TB wire map.pdf

# DB37 to Phoenix Contact TB

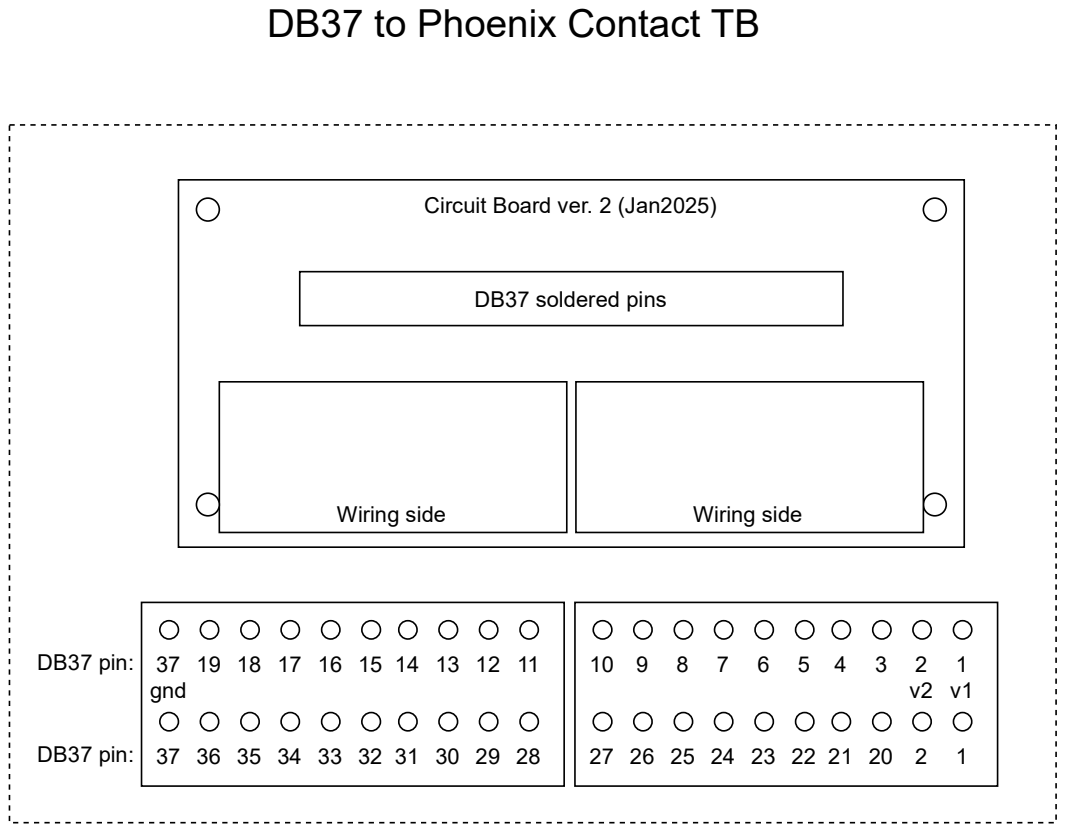
[picture p66: page 1]
37 gnd; DB37 pin:; DB37 soldered pins; Wiring side

Circuit Board ver. 2 (Jan2025)
