rosstimo/MotorProject/Mechanical/MotorCoupler/MotorCouplerDrawing.pdf

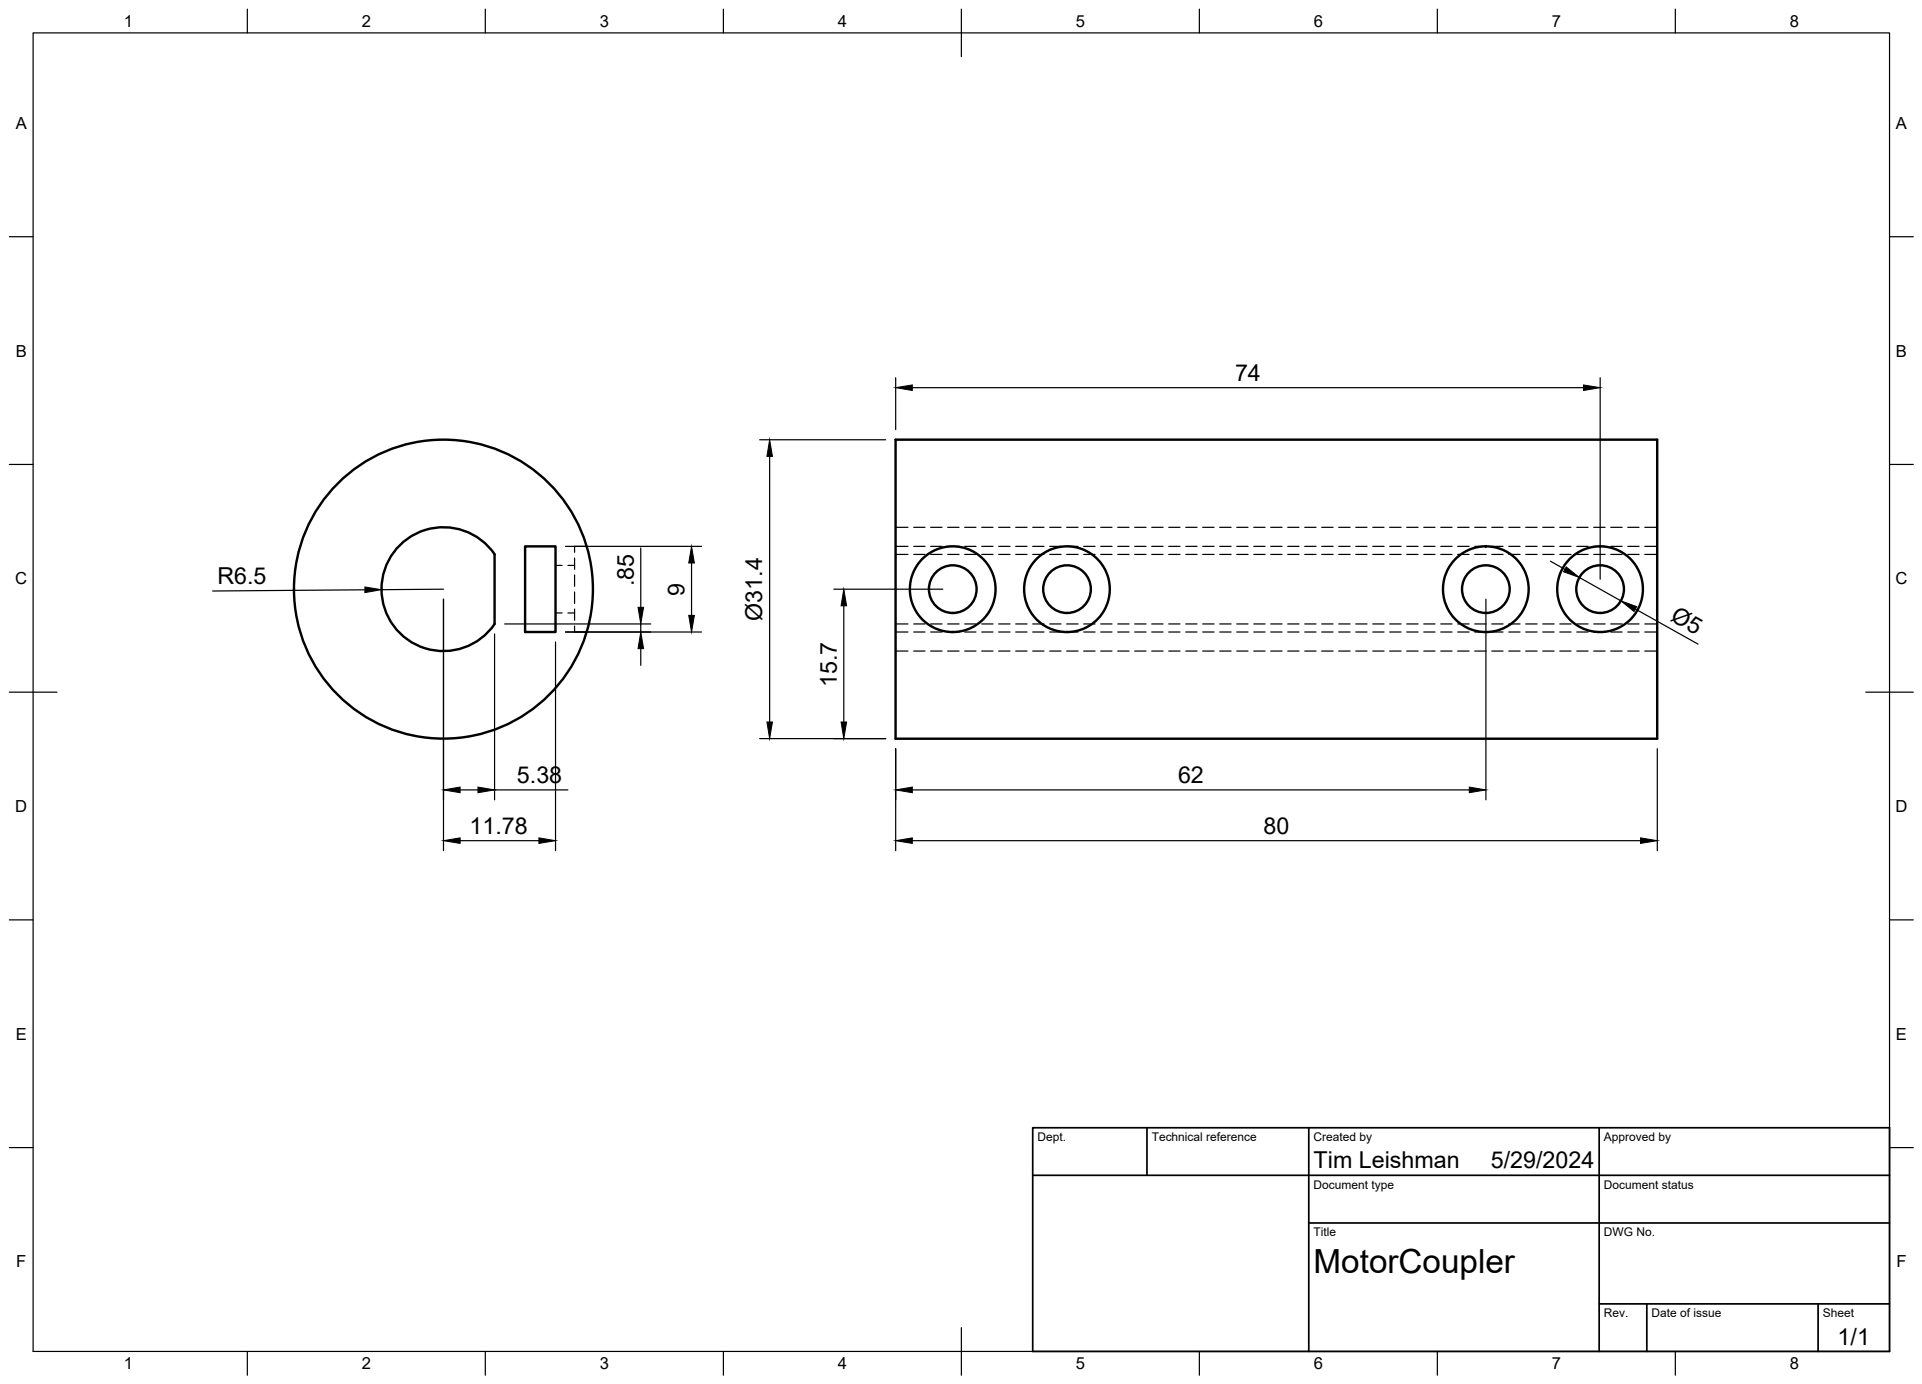
[picture p67: page 1]
Title; DWG No.; Rev.; Date of issue; Sheet

Dept. | Technical reference | Created by Tim Leishman 5/29/2024 | Approved by

Document type | Document status
