rosstimo/MotorProject/Mechanical/StopLightProject/Traffic_Light Drawing v1.pdf

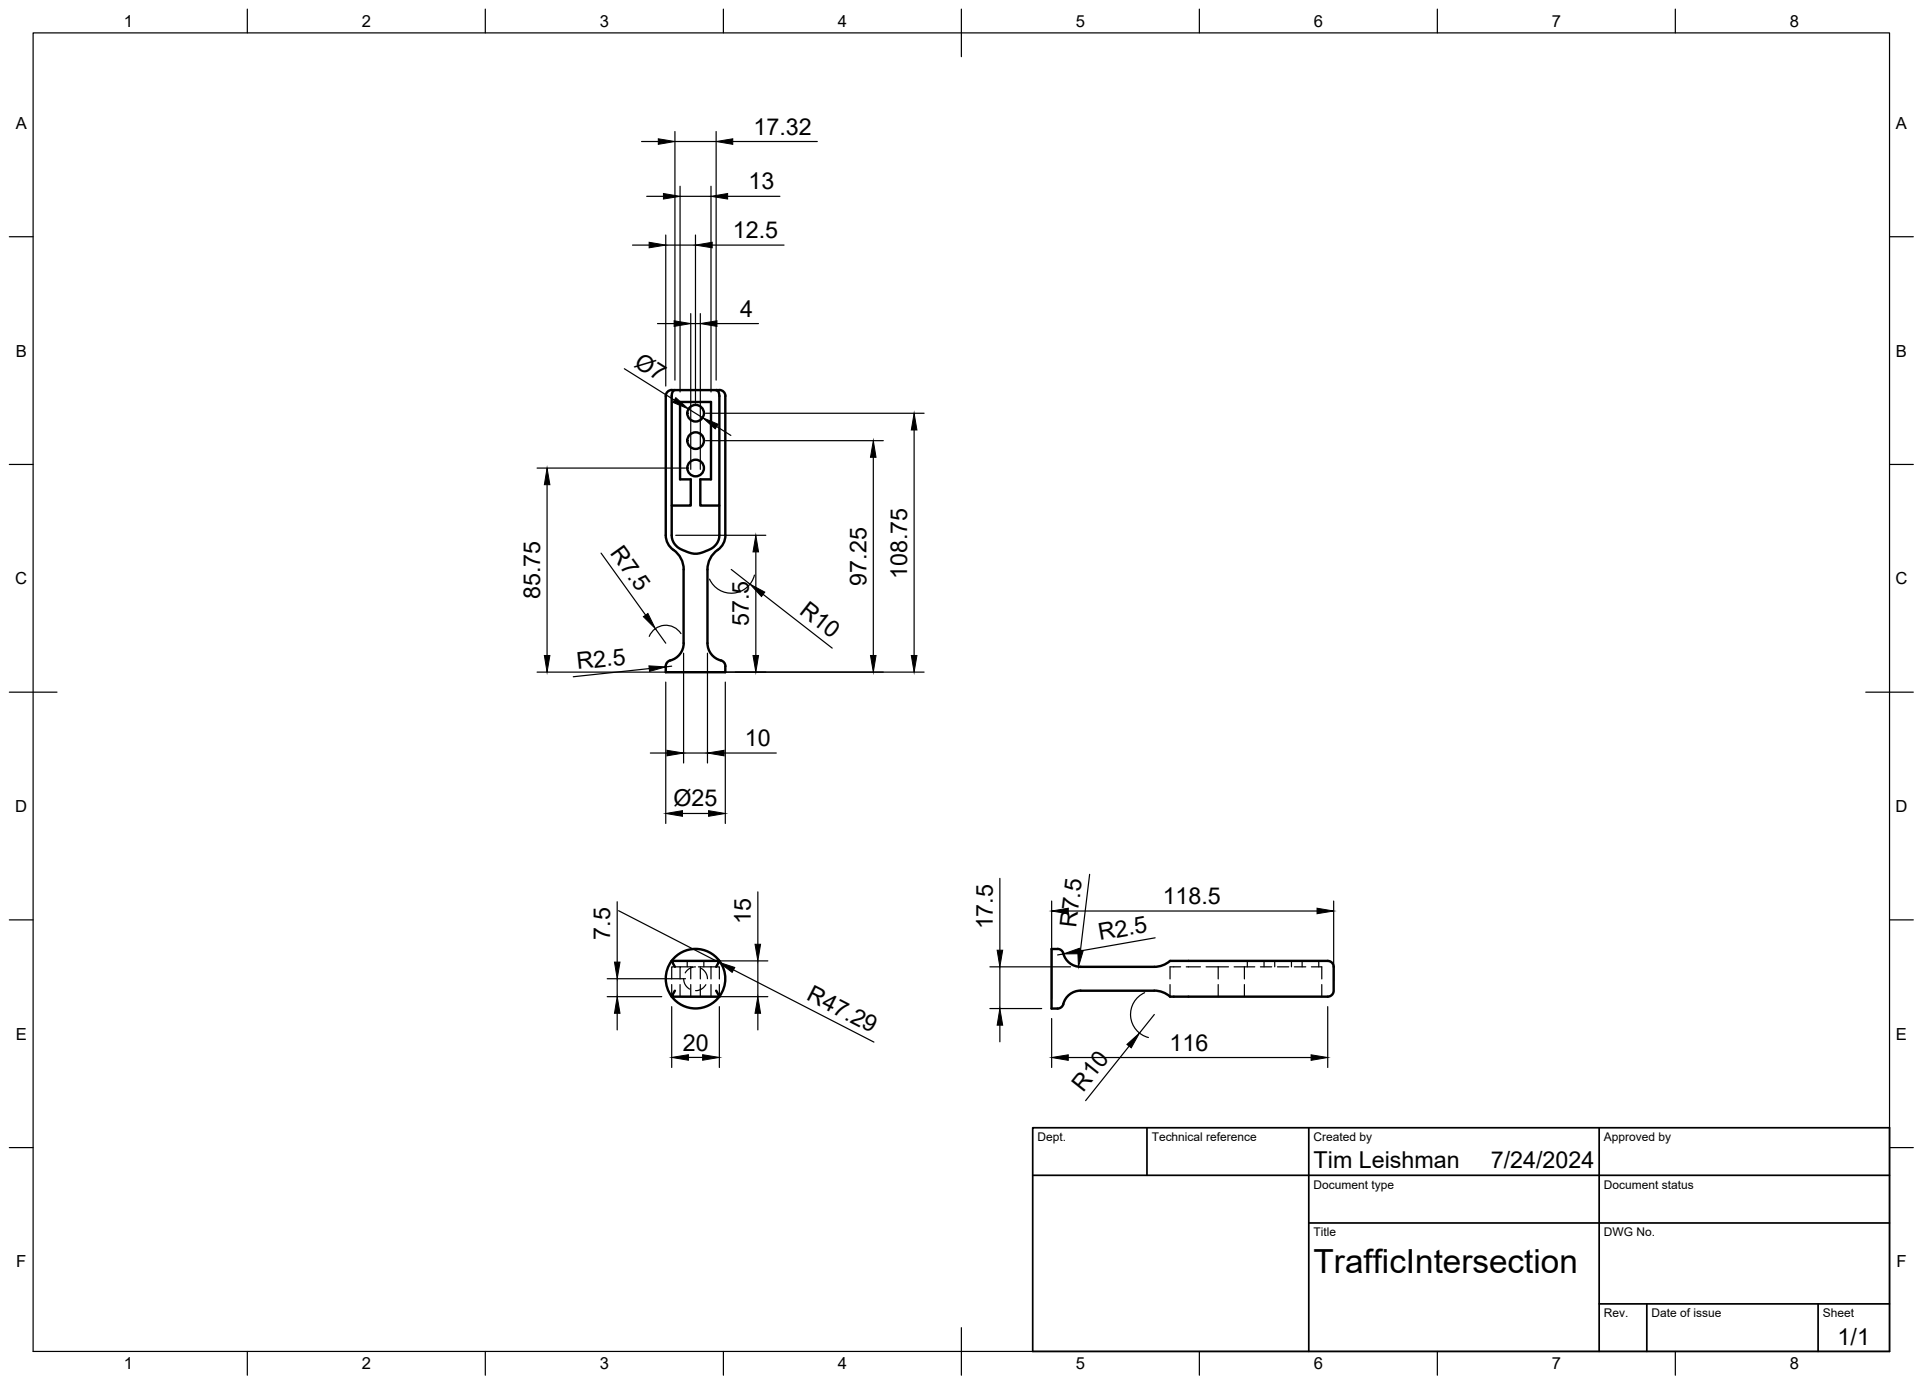
[picture p68: page 1]
Title; DWG No.; Rev.; Date of issue; Sheet

Dept. | Technical reference | Created by Tim Leishman 7/24/2024 | Approved by

Document type | Document status
