rosstimo/MotorProject/Mechanical/StopLightProject/TrafficIntersection Drawing v1.pdf

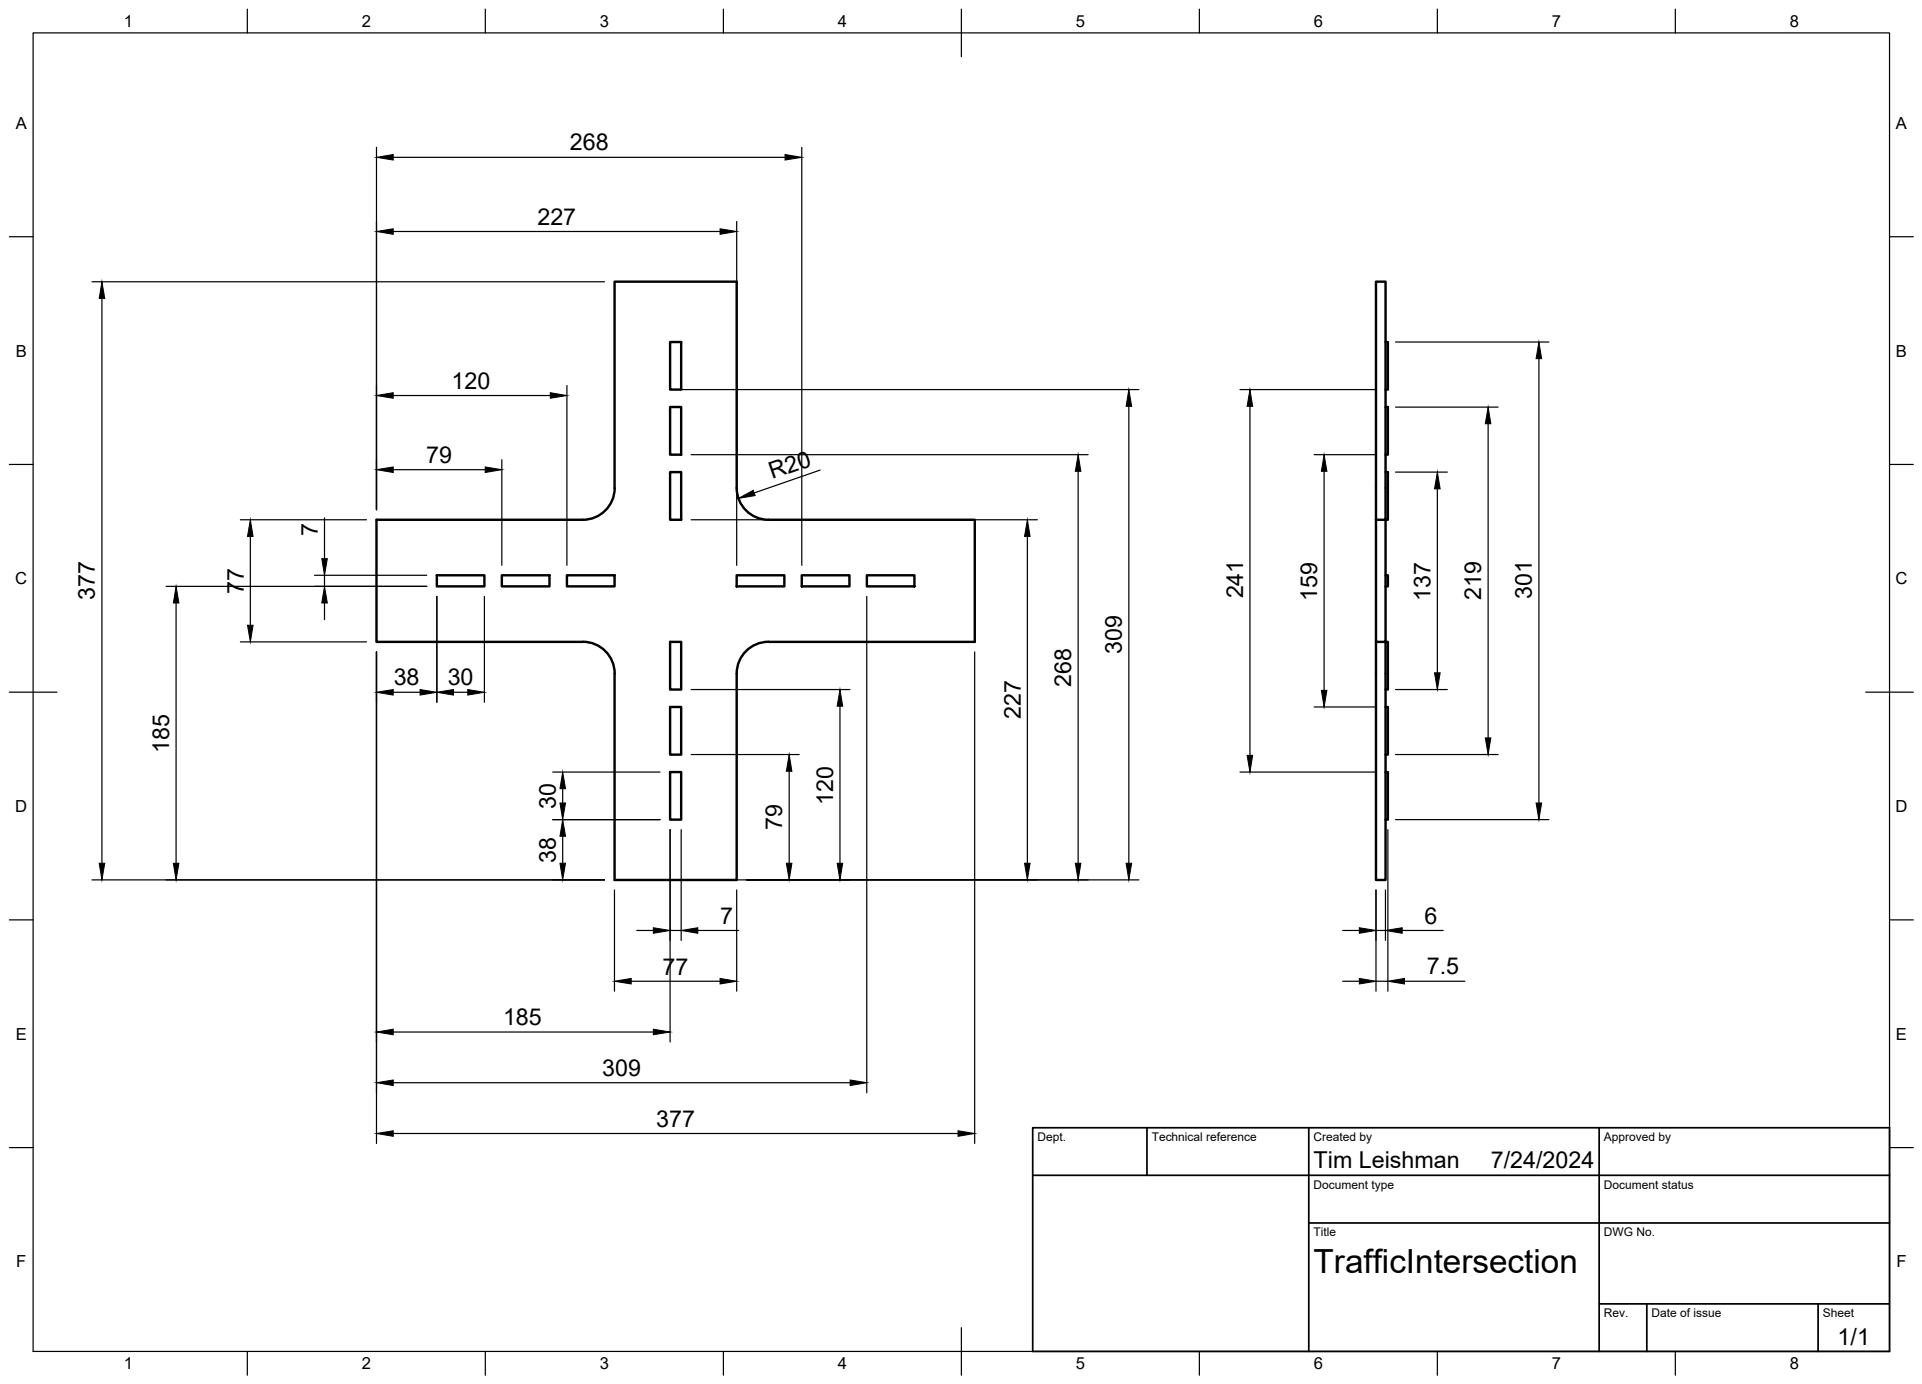
[picture p69: page 1]
Title; DWG No.; Rev.; Date of issue; Sheet; Tim Leishman 377

Dept. | Technical reference | Created by 7/24/2024 | Approved by

Document type | Document status
