rosstimo/MotorProject/Documentation/LaTeX files/images/SchematicV2.pdf

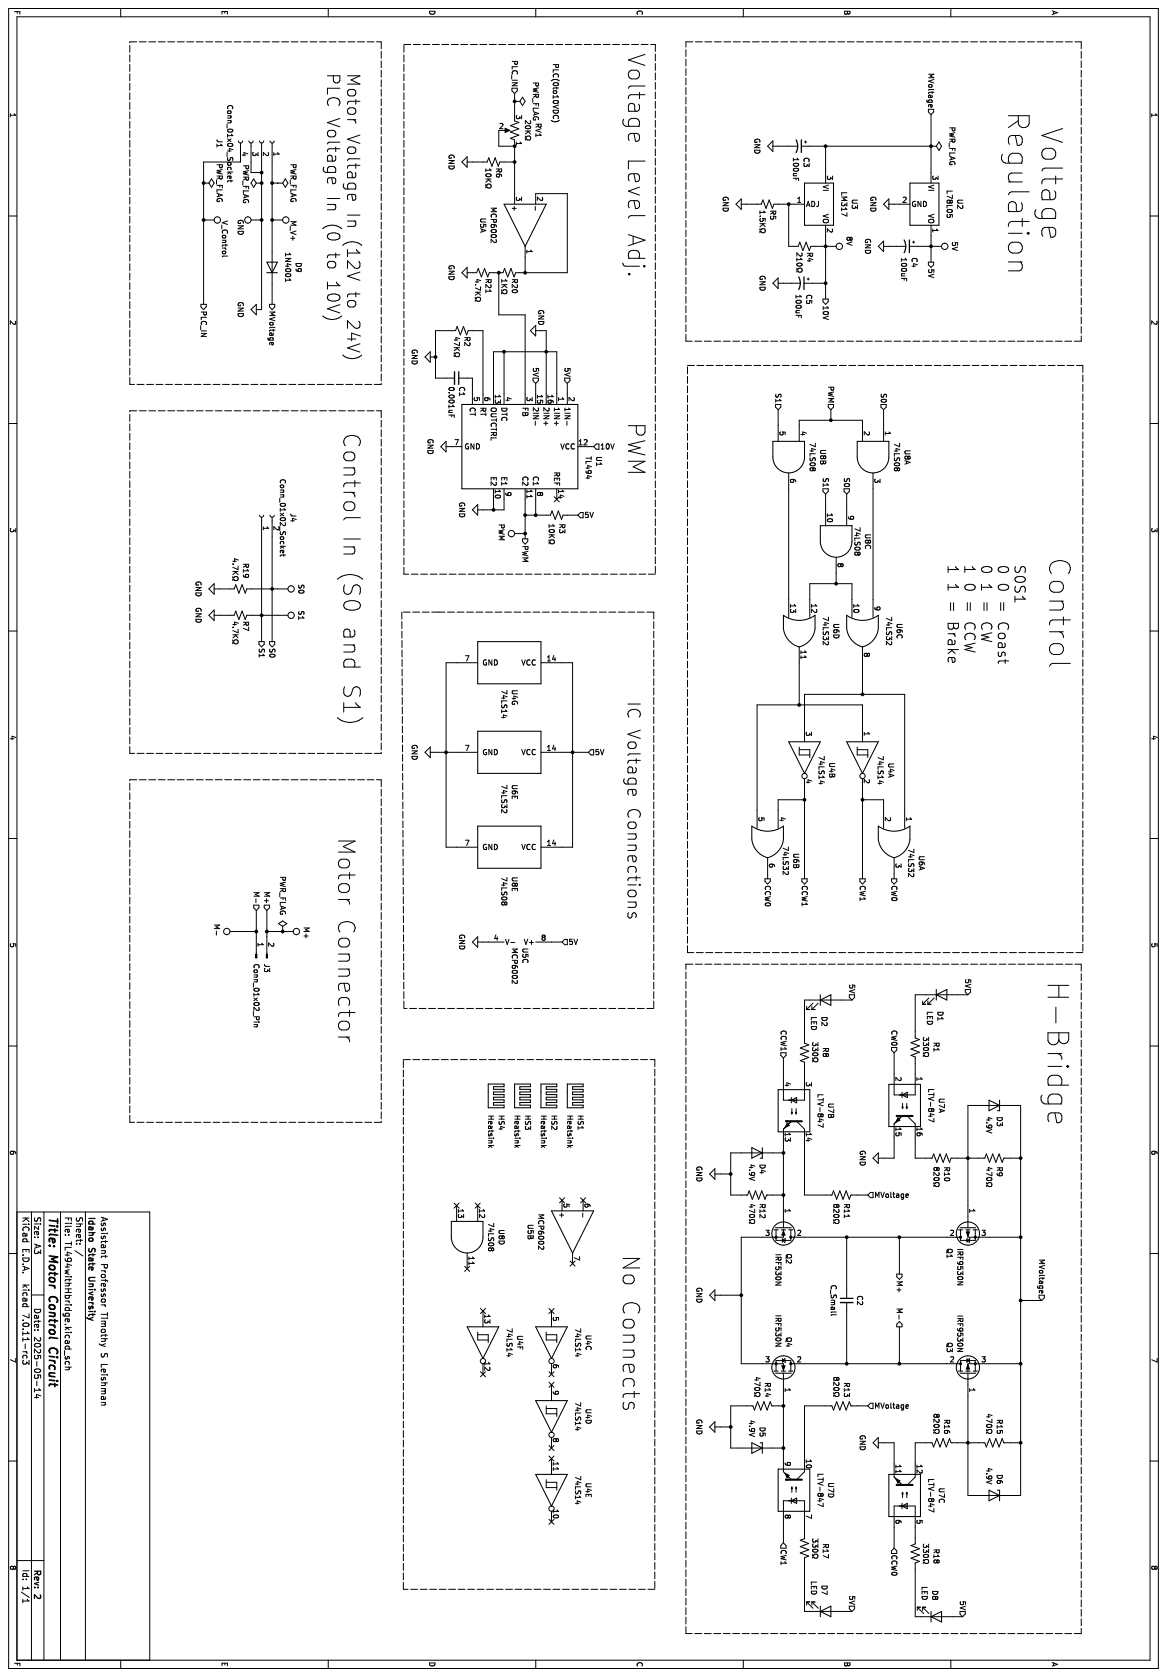
[picture p70: page 1]
