rosstimo/MotorProject/PCB/H_Bridge/H_Bridge_Schematic/H_BridgeSchematicV2.pdf

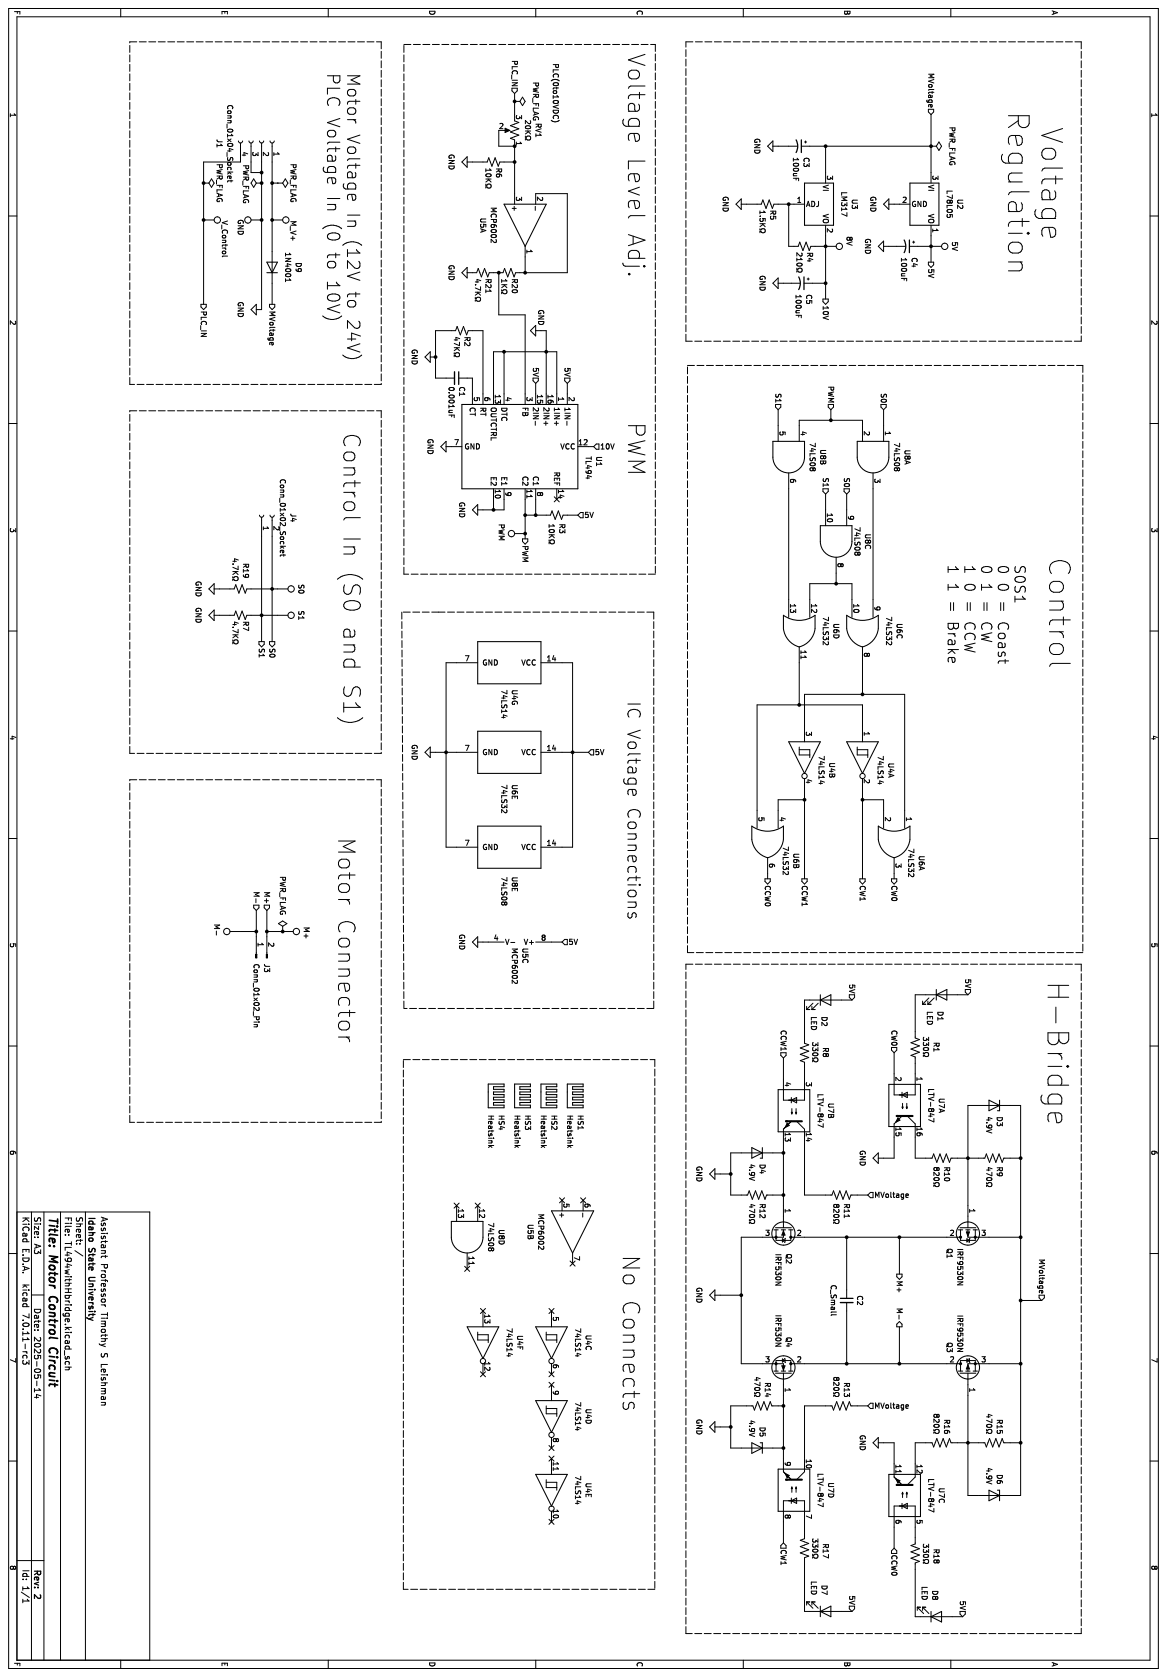
[picture p71: page 1]
