rosstimo/MotorProject/Documentation/LaTeX files/images/HeaterBox.pdf

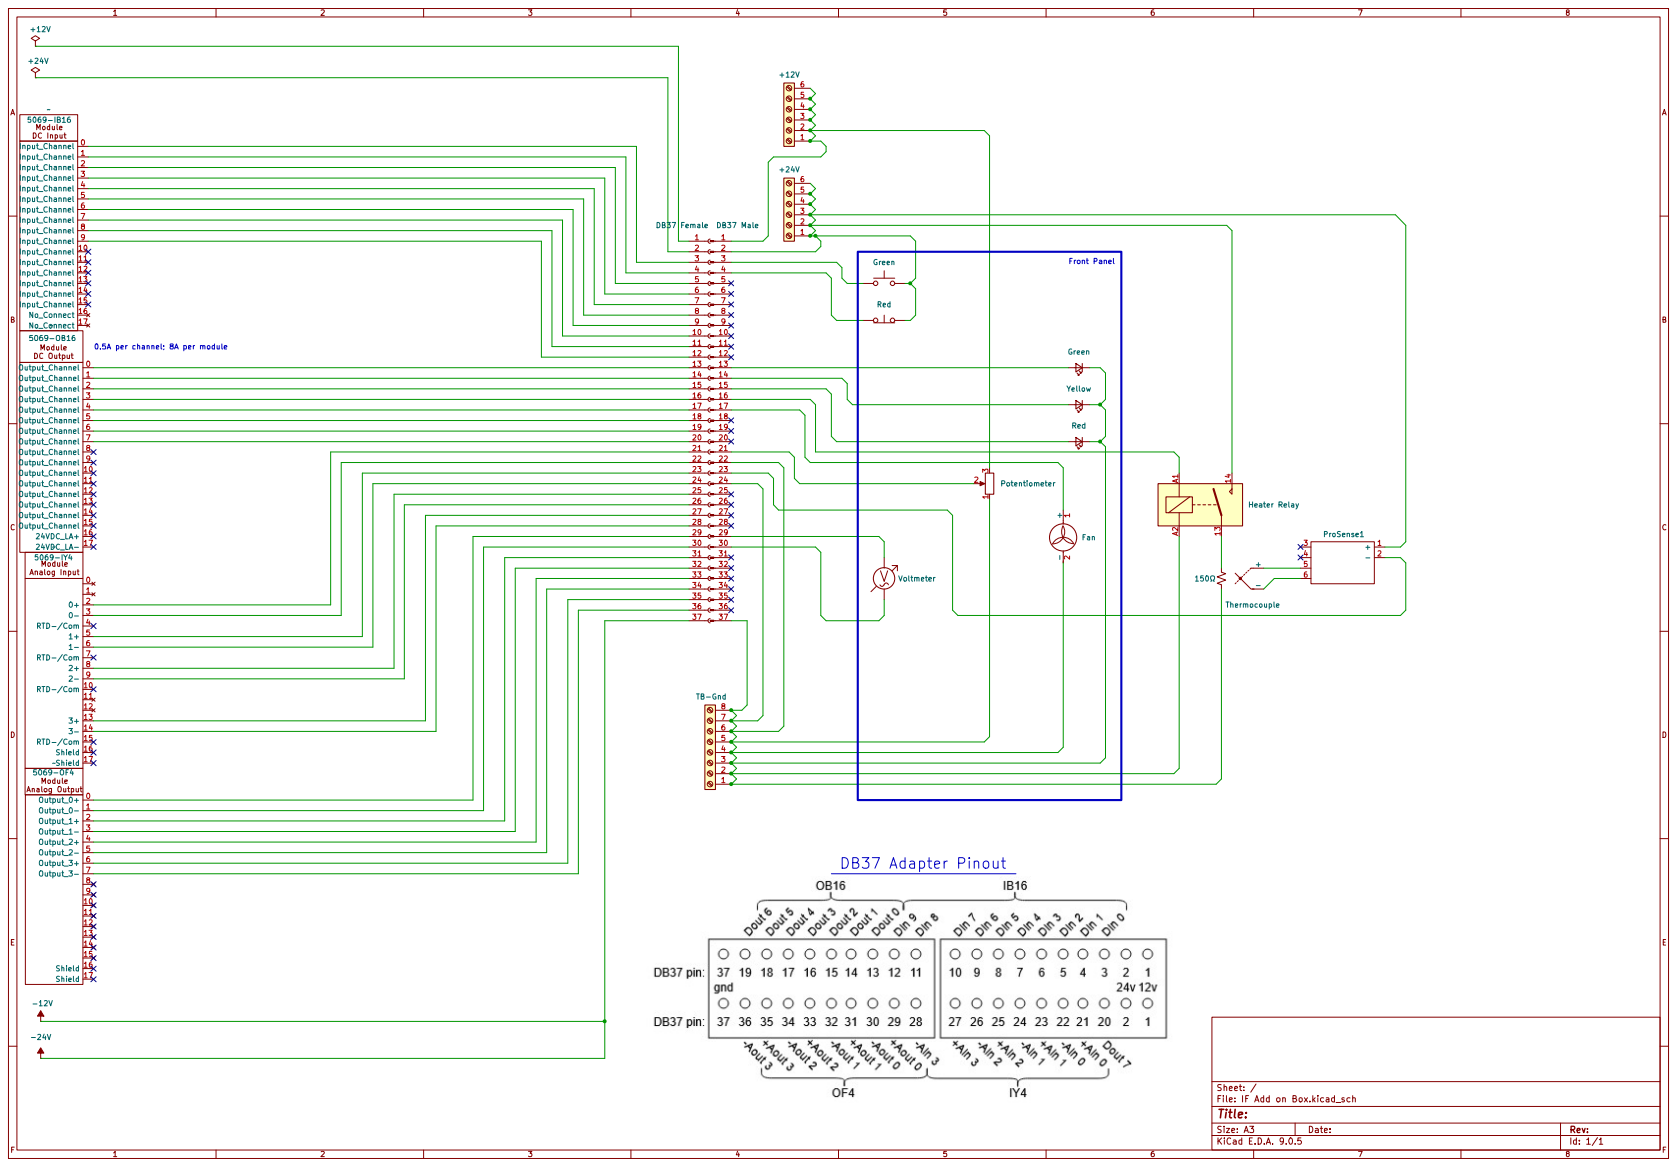
[picture p72: page 1]
