rosstimo/MotorProject/PCB/H_Bridge/H_Bridge_Schematic/H_BridgeSchematic.pdf

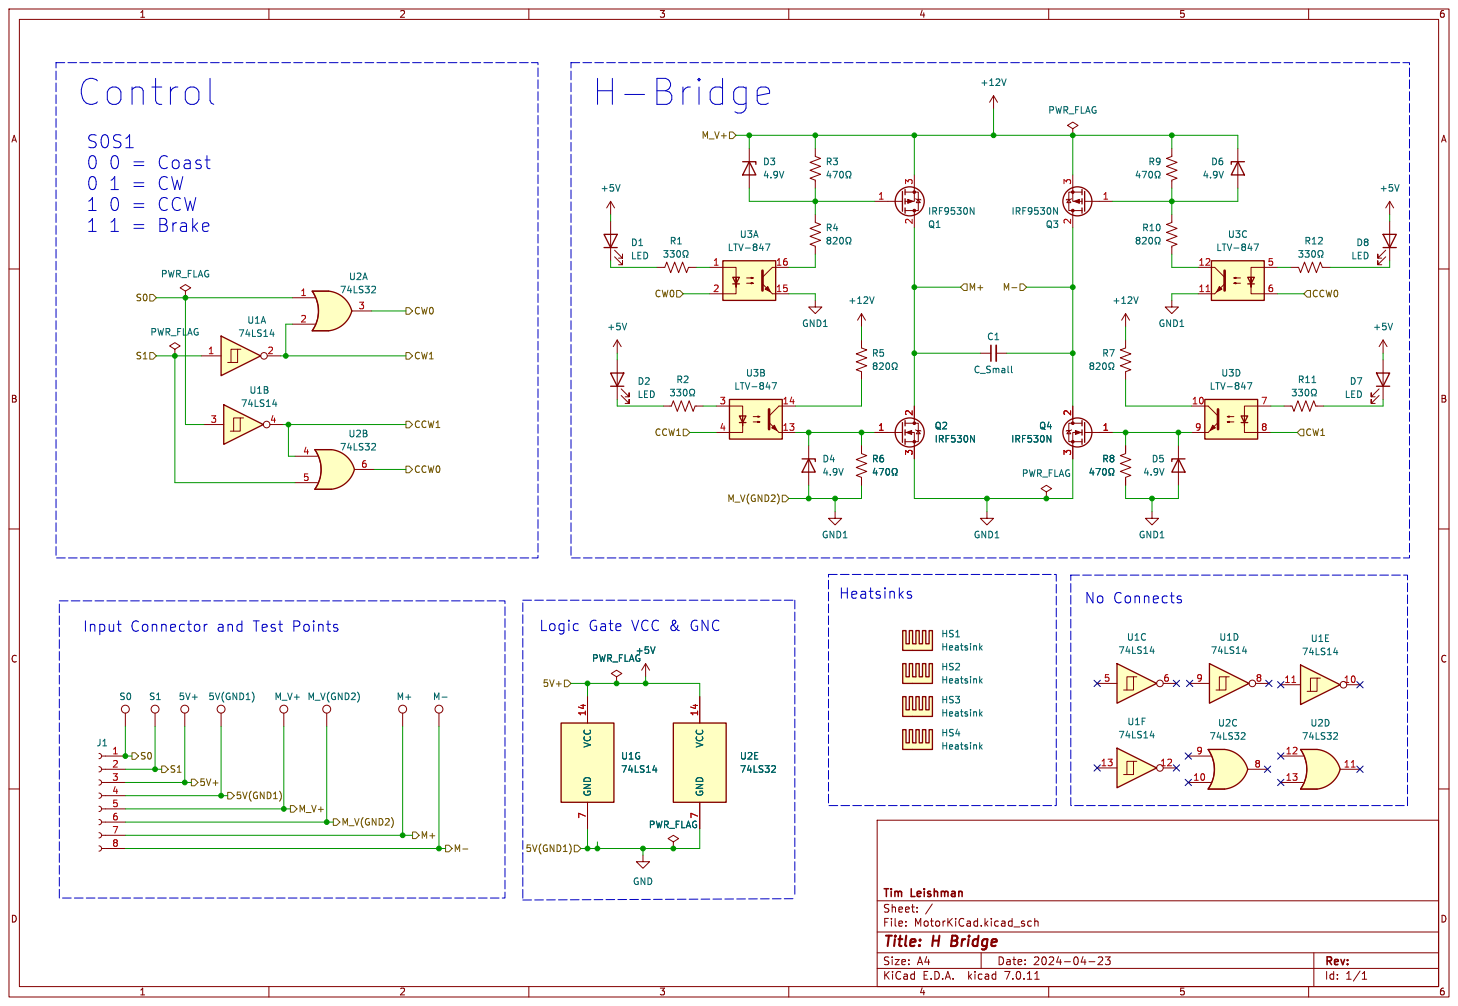
[picture p73: page 1]
