rosstimo/MotorProject/PCB/Anderson Projects/Pico_H-bridge_complete/Pico_H-bridge_complete.kicad_pcb

## KiCad design PCB/Anderson Projects/Pico_H-bridge_complete/Pico_H-bridge_complete.kicad_pcb (2026-04-19)

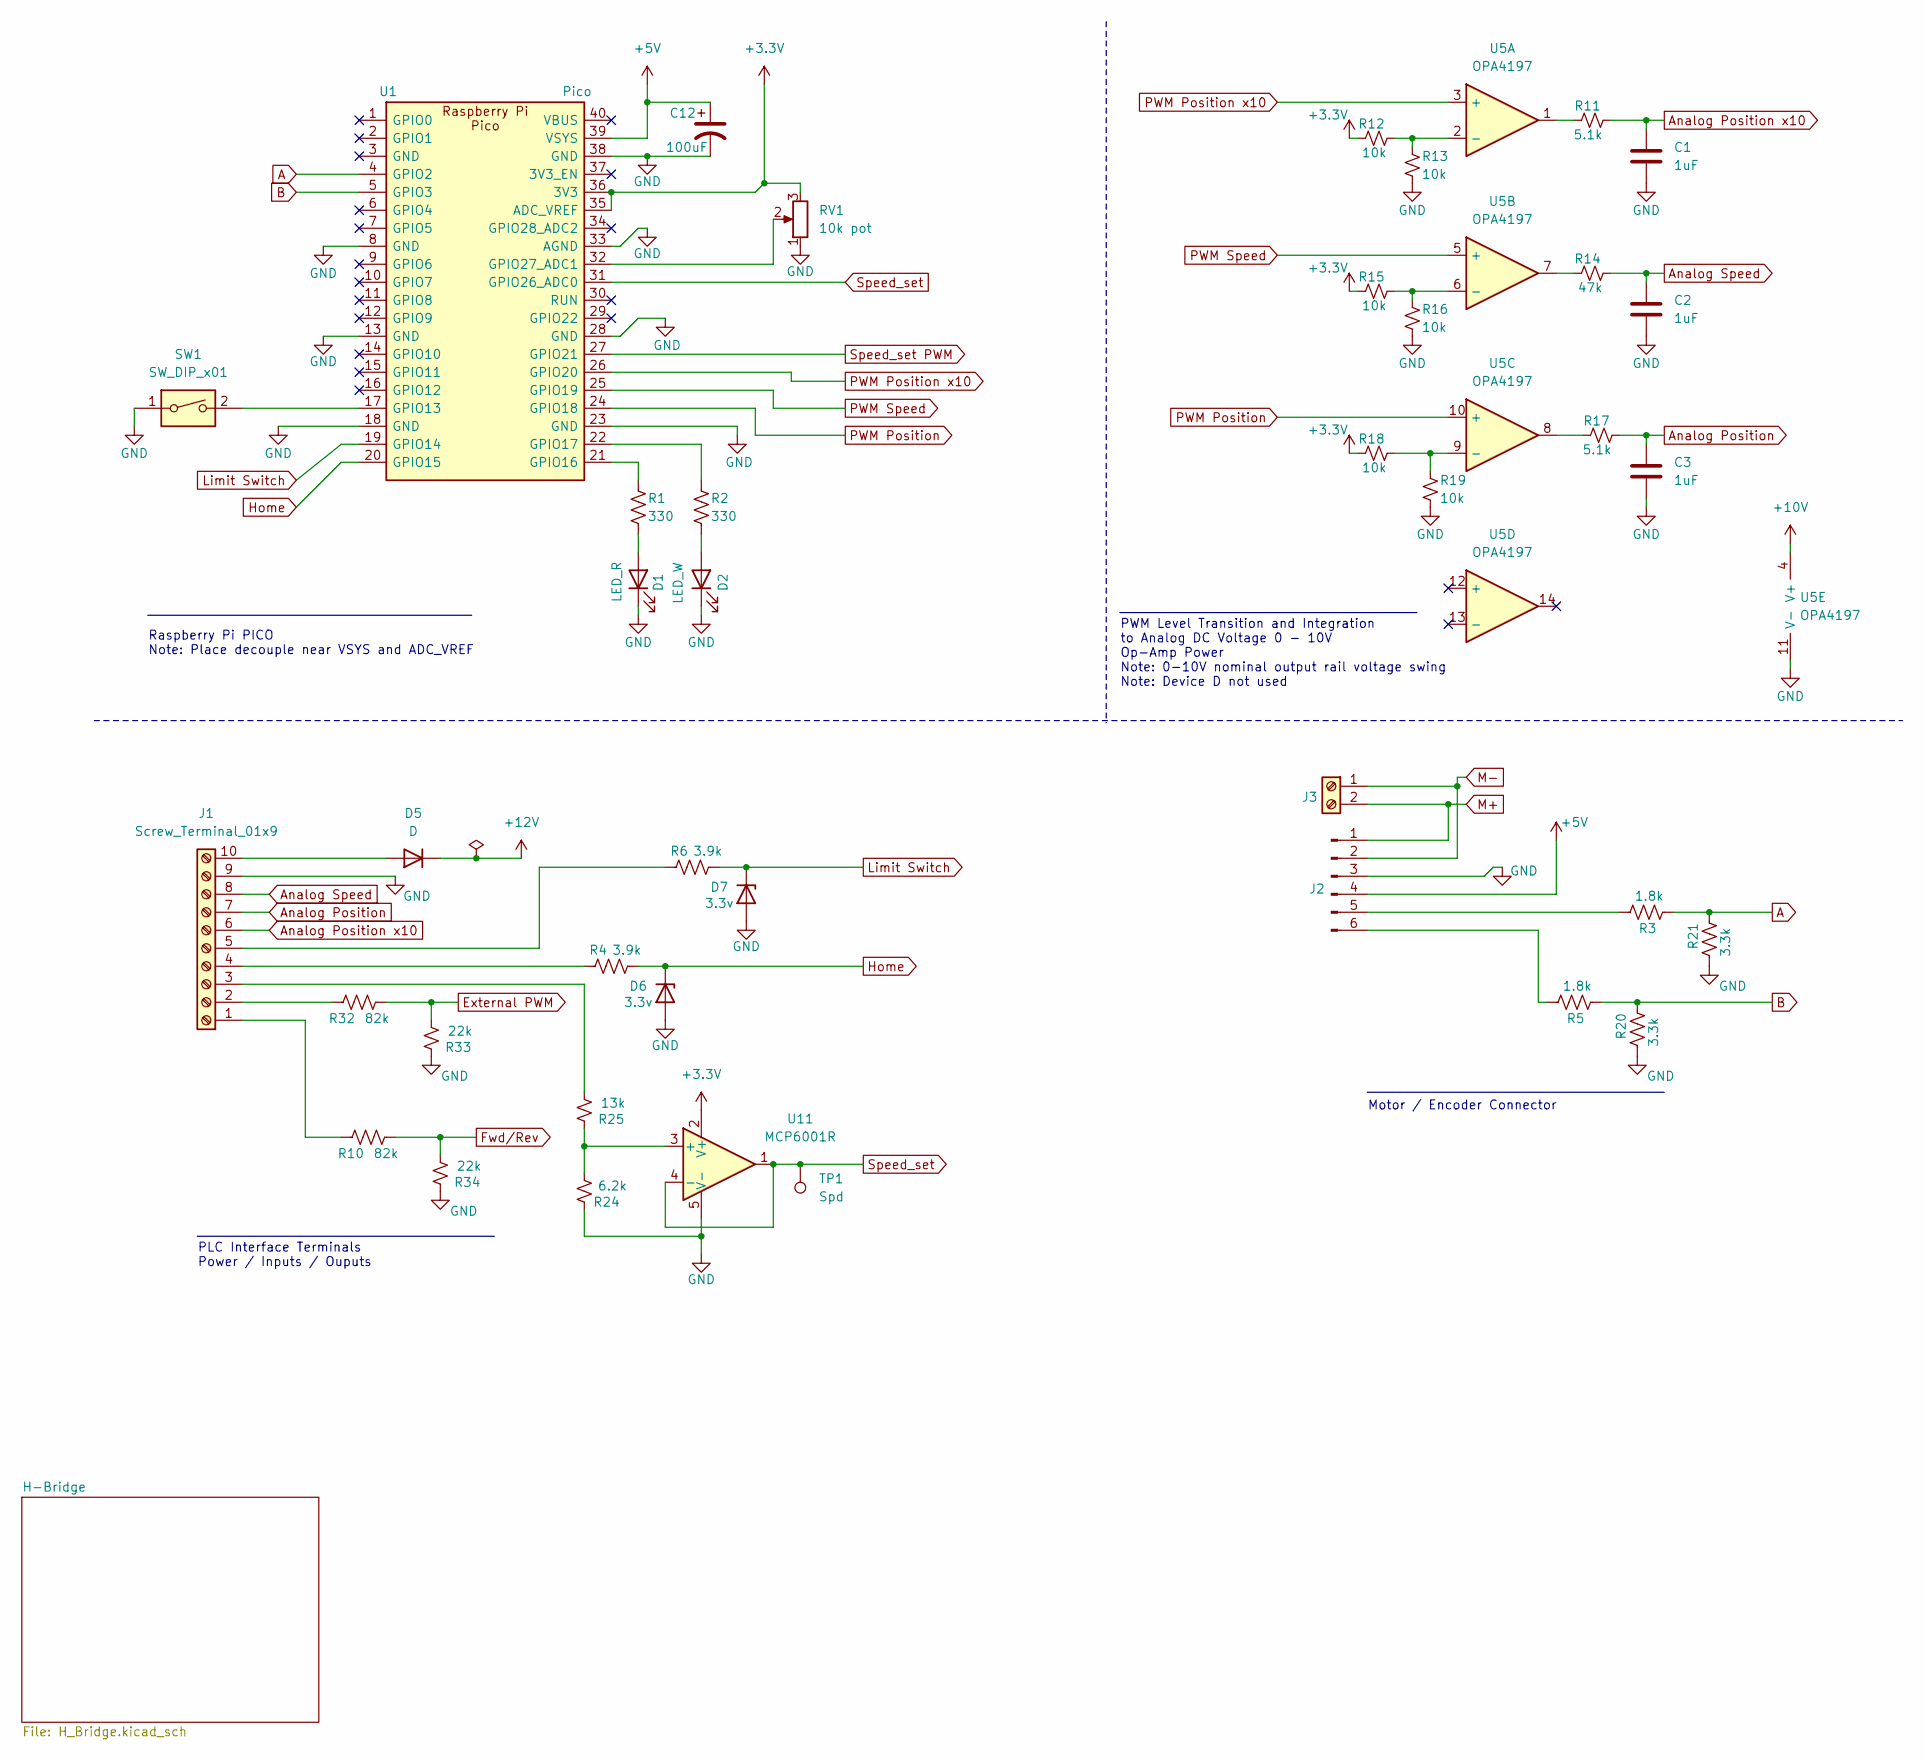
[picture p74: schematic Pico_H-bridge_complete.kicad_sch, PICO Motor Interface]

Parts:
C1, C2, C3: 1uF; C_1206_3216Metric; LCSC C2167419
C12: 100uF; C_1210_3225Metric; LCSC C23742
D1: LED_R; LED_0805_2012Metric; LCSC C84256
D2: LED_W; LED_0805_2012Metric; LCSC C34499
D5: D; D_SMA; LCSC C8678
D6, D7: 3.3v; D_SOD-323; LCSC C19077437
J1: Screw_Terminal_01x9; TerminalBlock_Phoenix_PT-1,5-10-5.0-H_1x10_P5.00mm_Horizont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
J2: Motor Connector; JST_XH_B6B-XH-A_1x06_P2.50mm_Vertical
J3: Screw_Terminal_01x02; TerminalBlock_Phoenix_MKDS-1,5-2_1x02_P5.00mm_Horizontal
R1, R2: 330; R_0805_2012Metric_Pad1.20x1.40mm_HandSolder; LCSC C17630
R3, R5: 1.8k; R_0805_2012Metric_Pad1.20x1.40mm_HandSolder; LCSC C17398
R4, R6: 3.9k; R_0805_2012Metric_Pad1.20x1.40mm_HandSolder; LCSC C17614
R10, R32: 82k; R_0805_2012Metric_Pad1.20x1.40mm_HandSolder; LCSC C17840
R11, R17: 5.1k; R_0805_2012Metric_Pad1.20x1.40mm_HandSolder; LCSC C27834
R12, R13, R15, R16, R18, R19: 10k; R_0805_2012Metric_Pad1.20x1.40mm_HandSolder; LCSC C17414
R14: 47k; R_0805_2012Metric_Pad1.20x1.40mm_HandSolder; LCSC C17713
R20, R21: 3.3k; R_0805_2012Metric_Pad1.20x1.40mm_HandSolder; LCSC C26010
R24: 6.2k; R_0805_2012Metric_Pad1.20x1.40mm_HandSolder; LCSC C17767
R25: 13k; R_0805_2012Metric_Pad1.20x1.40mm_HandSolder; LCSC C17455
R33, R34: 22k; R_0805_2012Metric_Pad1.20x1.40mm_HandSolder; LCSC C17560
RV1: 10k pot; Potentiometer_Bourns_3314J_Vertical; LCSC C36376
SW1: SW_DIP_x01; DIP_1x01_3.5_6.2mm; LCSC C600988
TP1: Spd; TestPoint_Plated_Hole_D2.0mm
U1: Pico; RaspberryPi_Pico
U5: OPA4197; SO-14_5.4_P1.27; LCSC C2058532
U11: MCP6001R; SOT-23-5; LCSC C154973

Connections:
+3.3V: R12.1, R15.1, R18.1, RV1.3, U1.35 (ADC_VREF), U1.36 (3V3), U11.2 (V+)
+5V: C12.1, J2.4, U1.39 (VSYS); also elsewhere on the board
+10V: U5.4 (V+); also elsewhere on the board
+12V: D5.1 (K); also elsewhere on the board
A: R3.2, R21.1, U1.4 (GPIO2)
Analog Position: C3.1, J1.7, R17.2
Analog Position x10: C1.1, J1.6, R11.2
Analog Speed: C2.1, J1.8, R14.2
B: R5.2, R20.1, U1.5 (GPIO3)
External PWM: R32.2, R33.2; also elsewhere on the board
Fwd/Rev: R10.2, R34.2; also elsewhere on the board
GND: C1.2, C2.2, C3.2, C12.2, D1.1 (K), D2.1 (K), D6.2 (A), D7.2 (A), J1.9, J2.3, R13.2, R16.2, R19.2, R20.2, R21.2, R24.1, R33.1, R34.1, RV1.1, SW1.1, U1.8 (GND), U1.13 (GND), U1.18 (GND), U1.23 (GND), U1.28 (GND), U1.33 (AGND), U1.38 (GND), U5.11 (V-), U11.5 (V-); also elsewhere on the board
Home: D6.1 (K), R4.2, U1.20 (GPIO15)
Limit Switch: D7.1 (K), R6.2, U1.19 (GPIO14)
M+: J2.1, J3.2; also elsewhere on the board
M-: J2.2, J3.1; also elsewhere on the board
unnamed: D1.2 (A), R1.2
unnamed: D2.2 (A), R2.2
unnamed: D5.2 (A), J1.10
unnamed: J1.1, R10.1
unnamed: J1.2, R32.1
unnamed: J1.3, R25.2
unnamed: J1.4, R4.1
unnamed: J1.5, R6.1
unnamed: J2.5, R3.1
unnamed: J2.6, R5.1
unnamed: R11.1, U5.1
unnamed: R14.1, U5.7
unnamed: R17.1, U5.8
unnamed: SW1.2, U1.17 (GPIO13)
unnamed: R1.1, U1.21 (GPIO16)
unnamed: R2.1, U1.22 (GPIO17)
unnamed: RV1.2, U1.32 (GPIO27_ADC1)
unnamed: R12.2, R13.1, U5.2 (-)
unnamed: R15.2, R16.1, U5.6 (-)
unnamed: R18.2, R19.1, U5.9 (-)
unnamed: R24.2, R25.1, U11.3 (+)
PWM Position: U1.24 (GPIO18), U5.10 (+)
PWM Position x10: U1.26 (GPIO20), U5.3 (+)
PWM Speed: U1.25 (GPIO19), U5.5 (+)
Speed_set: TP1.1, U1.31 (GPIO26_ADC0), U11.1, U11.4 (-)
Speed_set PWM: U1.27 (GPIO21); also elsewhere on the board

Notes on the sheet:
PWM Level Transition and Integration to Analog DC Voltage 0 - 10V Op-Amp Power Note: 0-10V nominal output rail voltage swing Note: Device D not used
PLC Interface Terminals Power / Inputs / Ouputs
Motor / Encoder Connector
Raspberry Pi PICO Note: Place decouple near VSYS and ADC_VREF

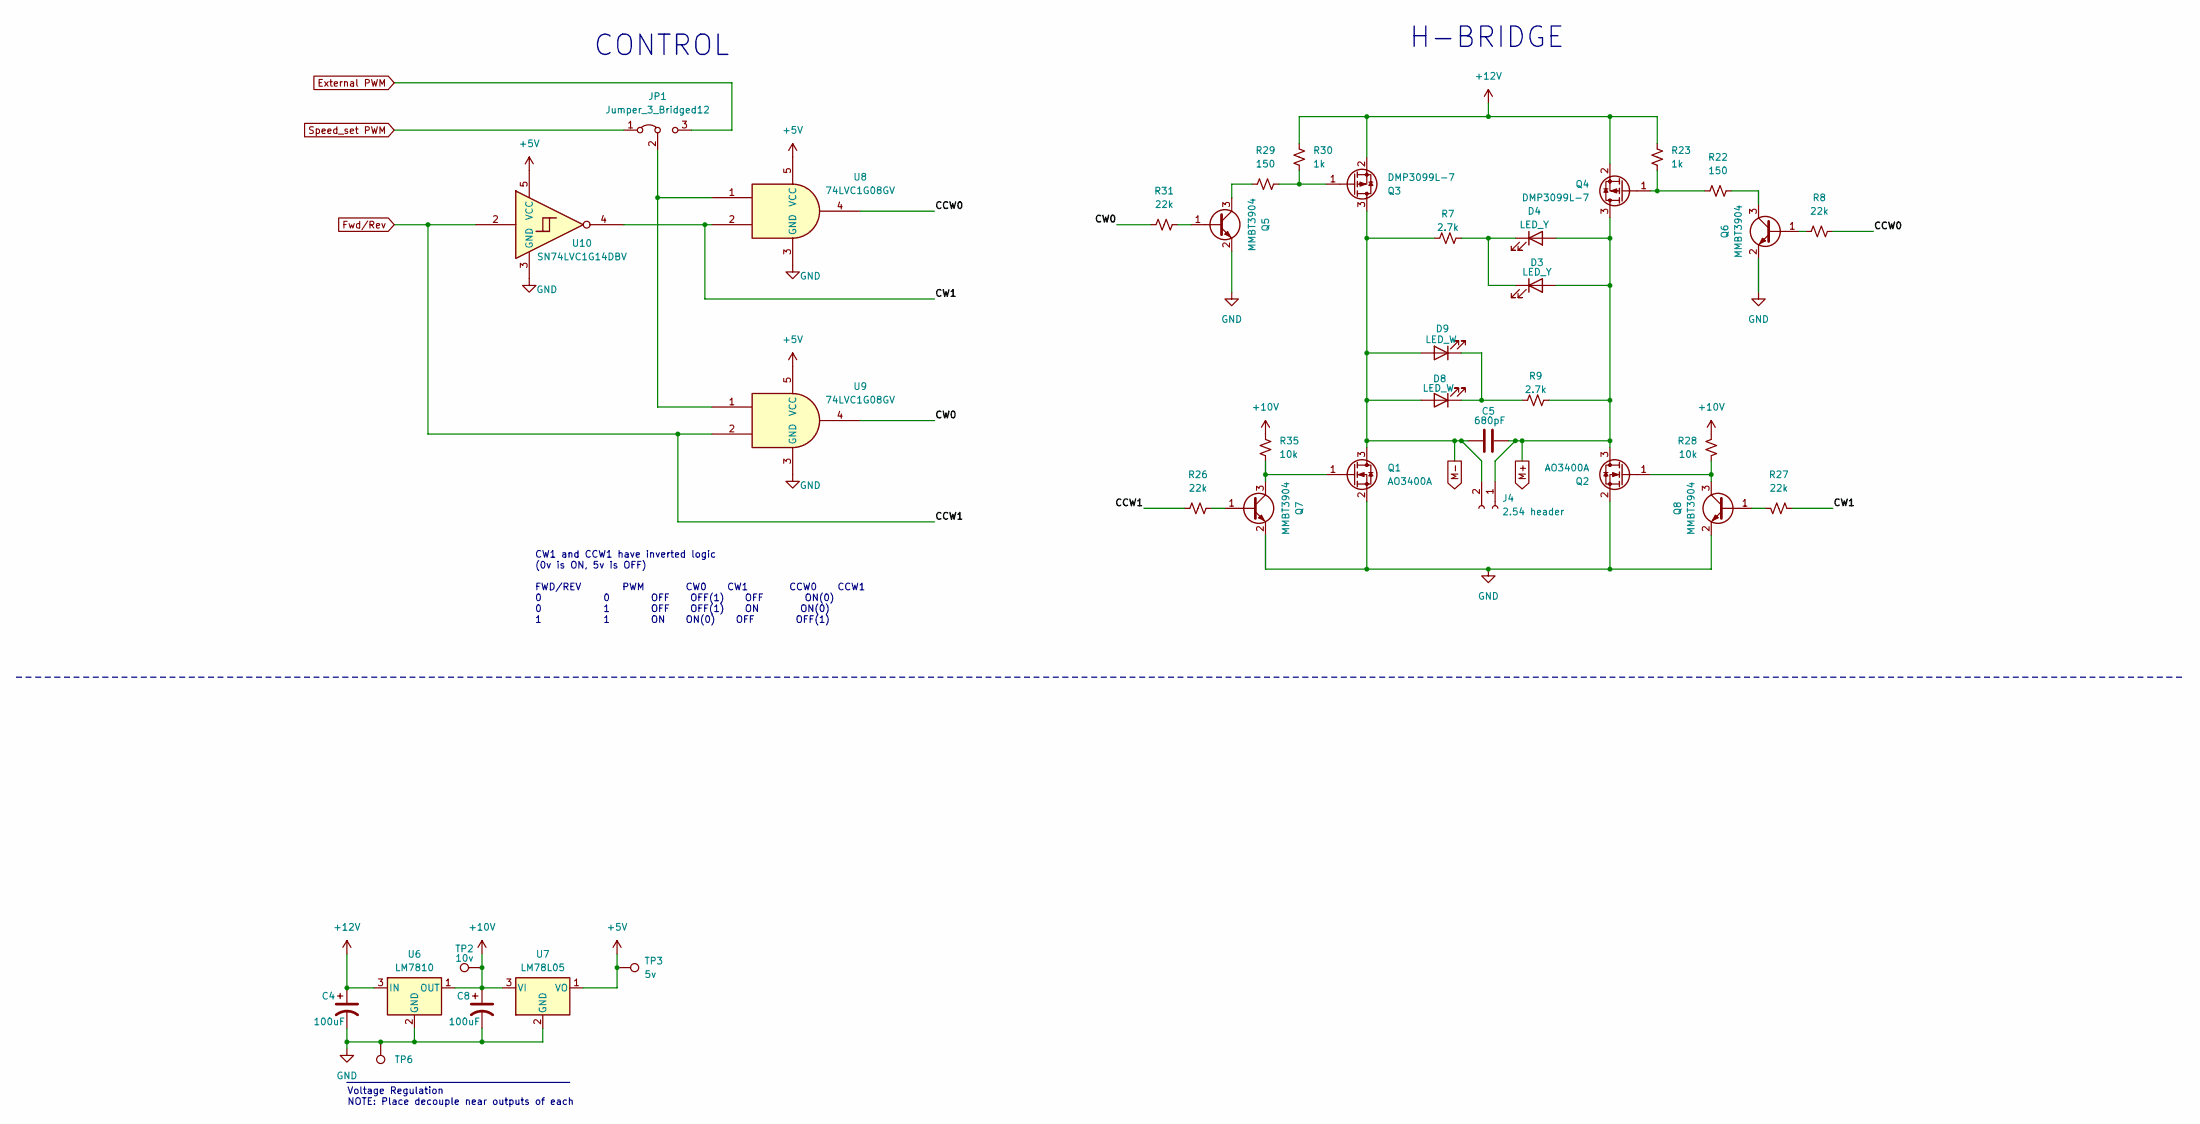
[picture p75: schematic H_Bridge.kicad_sch]

Parts:
C4, C8: 100uF; C_1210_3225Metric; LCSC C23742
C5: 680pF; C_0603_1608Metric; LCSC C1630
D3, D4: LED_Y; LED_0603_1608Metric; LCSC C2286
D8, D9: LED_W; LED_0603_1608Metric; LCSC C2290
J4: 2.54 header; PinHeader_1x02_P2.54mm_Vertical
JP1: Jumper_3_Bridged12; PinHeader_1x03_P2.54mm_Vertical
Q1, Q2: AO3400A; SOT-23; LCSC C20917
Q3, Q4: DMP3099L-7; SOT-23; LCSC C155244
Q5, Q6, Q7, Q8: MMBT3904; SOT-23; LCSC C20526
R7, R9: 2.7k; R_0805_2012Metric_Pad1.20x1.40mm_HandSolder; LCSC C17530
R8, R26, R27, R31: 22k; R_0805_2012Metric_Pad1.20x1.40mm_HandSolder; LCSC C17560
R22, R29: 150; R_0805_2012Metric_Pad1.20x1.40mm_HandSolder; LCSC C17471
R23, R30: 1k; R_0805_2012Metric_Pad1.20x1.40mm_HandSolder; LCSC C17513
R28, R35: 10k; R_0805_2012Metric_Pad1.20x1.40mm_HandSolder; LCSC C17414
TP2: 10v; TestPoint_Plated_Hole_D2.0mm
TP3: 5v; TestPoint_Plated_Hole_D2.0mm
TP6: GND; TestPoint_Loop_D2.60mm_Drill1.4mm_Beaded
U6: LM7810; SOT-89-3; LCSC C122848
U7: LM78L05; SOT-89-3; LCSC C347258
U8, U9: 74LVC1G08GV; SOT-23-5; LCSC C19829591
U10: SN74LVC1G14DBV; SOT-23-5; LCSC C7835

Connections:
+5V: TP3.1, U7.1 (VO), U8.5 (VCC), U9.5 (VCC), U10.5 (VCC); also elsewhere on the board
+10V: C8.1, R28.1, R35.1, TP2.1, U6.1 (OUT), U7.3 (VI); also elsewhere on the board
+12V: C4.1, Q3.2 (S), Q4.2 (S), R23.2, R30.2, U6.3 (IN); also elsewhere on the board
/H-Bridge/CCW0: R8.2, U8.4
/H-Bridge/CW0: R31.1, U9.4
/H-Bridge/CW1: R27.1, U8.2, U10.4
External PWM: JP1.3 (B); also elsewhere on the board
Fwd/Rev: R26.1, U9.2, U10.2; also elsewhere on the board
GND: C4.2, C8.2, Q1.2 (S), Q2.2 (S), Q5.2 (E), Q6.2 (E), Q7.2 (E), Q8.2 (E), TP6.1, U6.2 (GND), U7.2 (GND), U8.3 (GND), U9.3 (GND), U10.3 (GND); also elsewhere on the board
M+: C5.2, D3.2 (A), D4.2 (A), J4.1, Q2.3 (D), Q4.3 (D), R9.1; also elsewhere on the board
M-: C5.1, D8.2 (A), D9.2 (A), J4.2, Q1.3 (D), Q3.3 (D), R7.2; also elsewhere on the board
unnamed: D3.1 (K), D4.1 (K), R7.1
unnamed: D8.1 (K), D9.1 (K), R9.2
unnamed: JP1.2 (C), U8.1, U9.1
unnamed: Q1.1 (G), Q7.3 (C), R35.2
unnamed: Q2.1 (G), Q8.3 (C), R28.2
unnamed: Q3.1 (G), R29.2, R30.1
unnamed: Q4.1 (G), R22.1, R23.1
unnamed: Q5.1 (B), R31.2
unnamed: Q5.3 (C), R29.1
unnamed: Q6.1 (B), R8.1
unnamed: Q6.3 (C), R22.2
unnamed: Q7.1 (B), R26.2
unnamed: Q8.1 (B), R27.2
Speed_set PWM: JP1.1 (A); also elsewhere on the board

Notes on the sheet:
Voltage Regulation NOTE: Place decouple near outputs of each
CONTROL
CW1 and CCW1 have inverted logic (0v is ON, 5v is OFF) FWD/REV PWM CW0 CW1 CCW0 CCW1 0 0 OFF OFF(1) OFF ON(0) 0 1 OFF OFF(1) ON ON(0) 1 1 ON ON(0) OFF OFF(1)
H-BRIDGE

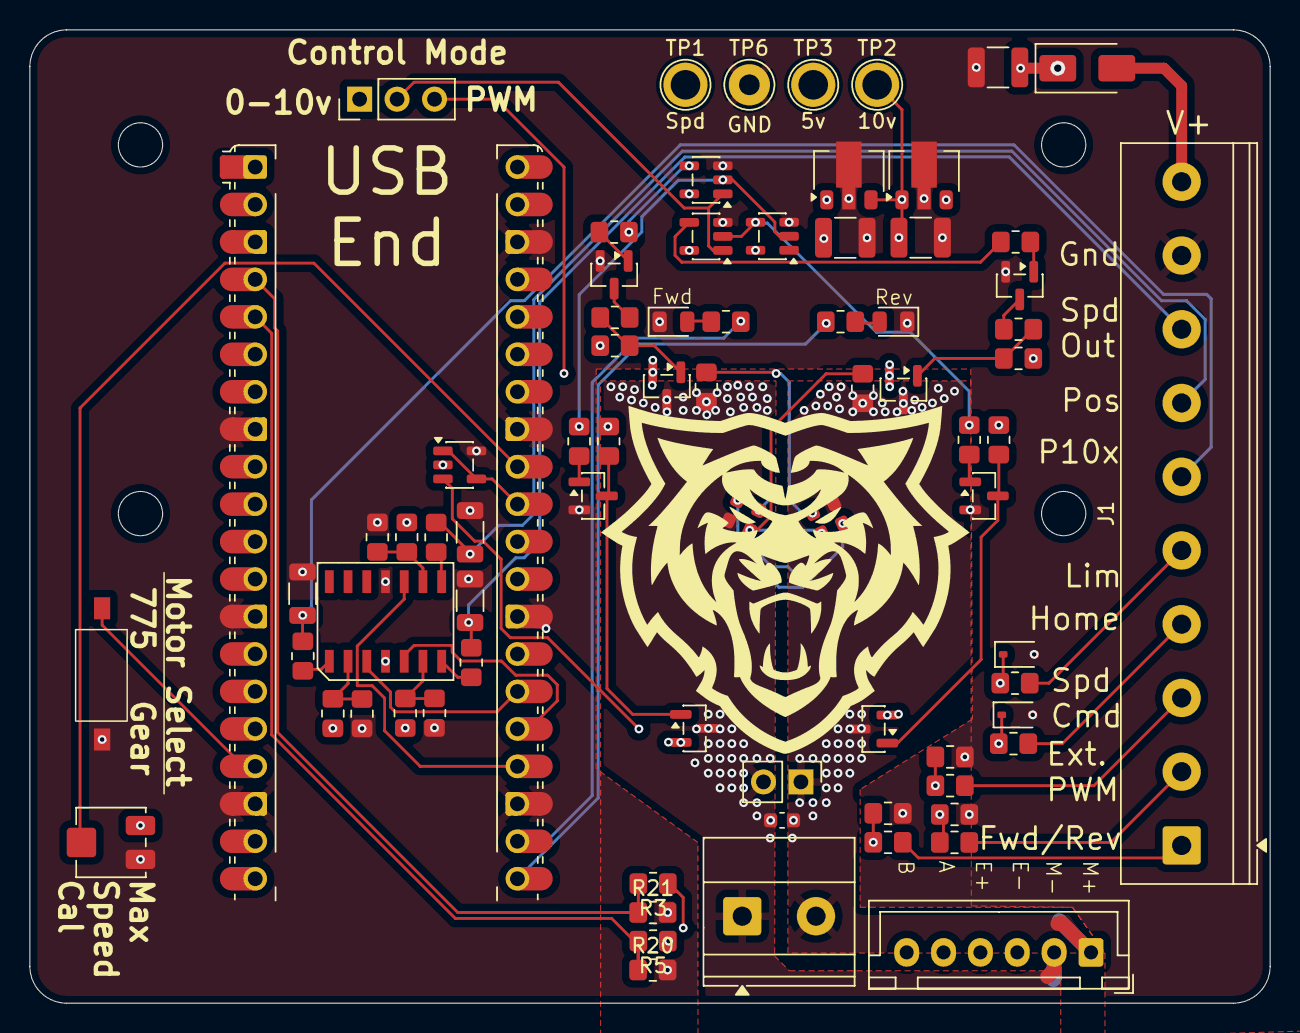
[picture p76: board Pico_H-bridge_complete.kicad_pcb from above]

Board: 4 copper layers, 84.1 x 66.0 mm, 79 parts (0 on the bottom side), 58 nets.

Other parts of the board:
logo1: LOGO; Bengal_25_25(negative)
