rosstimo/MotorProject/PCB/Anderson Projects/DB37 passthrough/IF Box PCB.kicad_pcb

## KiCad design PCB/Anderson Projects/DB37 passthrough/IF Box PCB.kicad_pcb (2025-05-12)

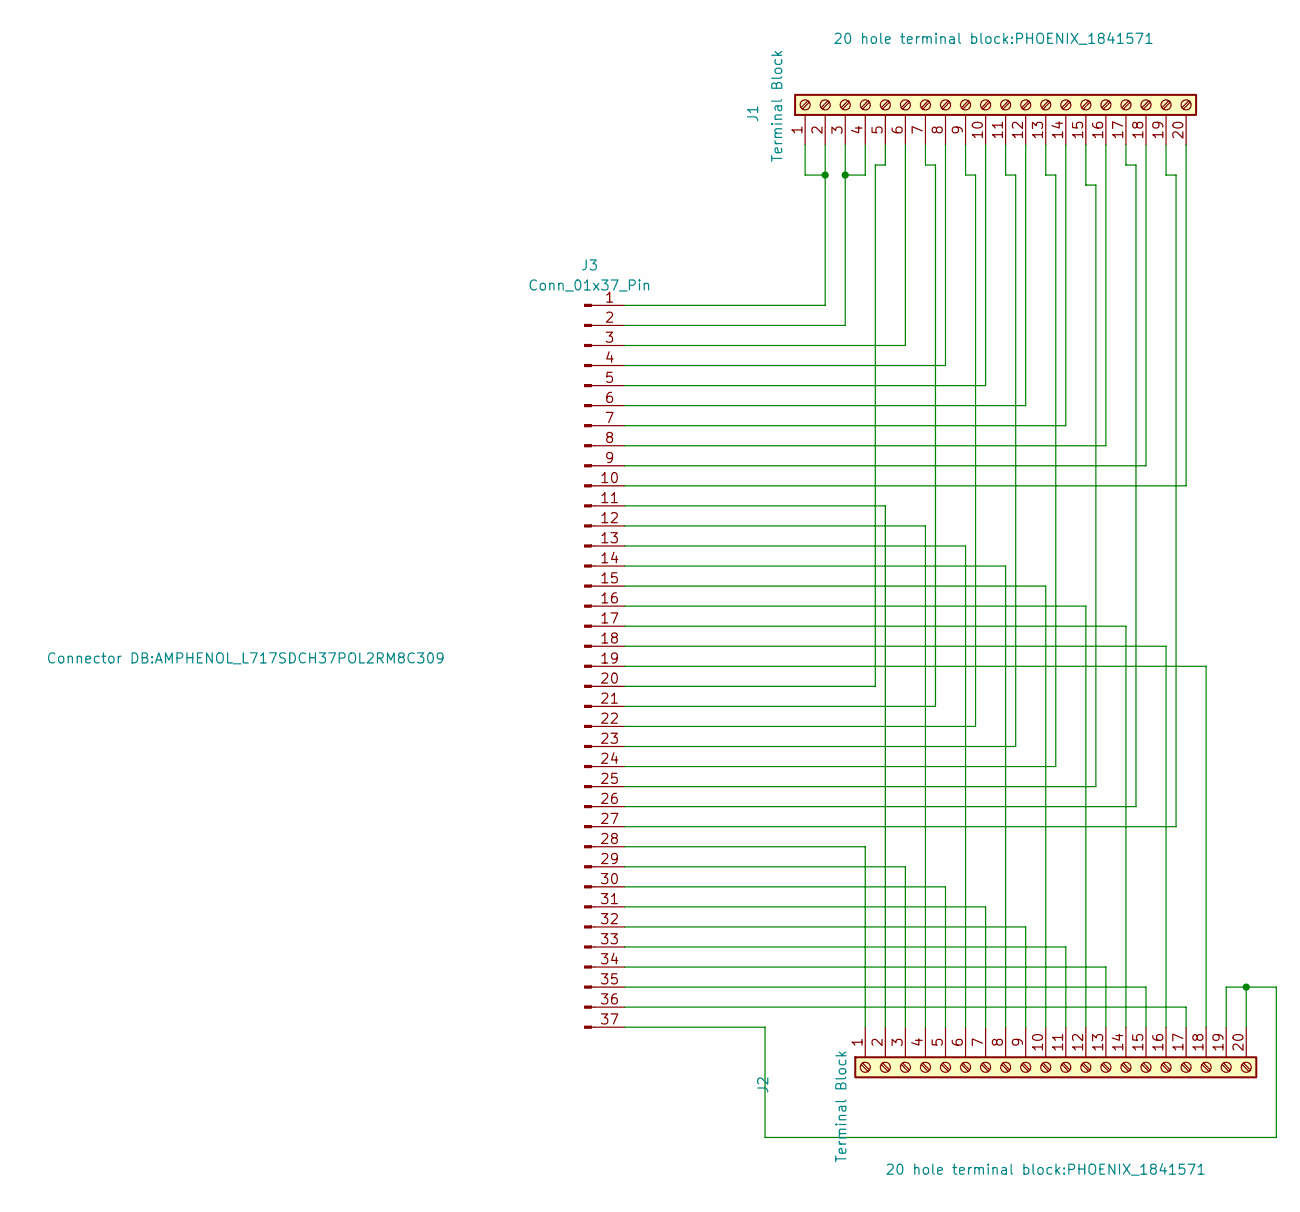
[picture p77: schematic IF Box PCB.kicad_sch]

Parts:
J1, J2: Terminal Block; PHOENIX_1841571
J3: Conn_01x37_Pin; AMPHENOL_L717SDCH37POL2RM8C309

Connections:
unnamed: J1.1, J1.2, J3.1
unnamed: J1.3, J1.4, J3.2
unnamed: J1.5, J3.20
unnamed: J1.6, J3.3
unnamed: J1.7, J3.21
unnamed: J1.8, J3.4
unnamed: J1.9, J3.22
unnamed: J1.10, J3.5
unnamed: J1.11, J3.23
unnamed: J1.12, J3.6
unnamed: J1.13, J3.24
unnamed: J1.14, J3.7
unnamed: J1.15, J3.25
unnamed: J1.16, J3.8
unnamed: J1.17, J3.26
unnamed: J1.18, J3.9
unnamed: J1.19, J3.27
unnamed: J1.20, J3.10
unnamed: J2.1, J3.28
unnamed: J2.2, J3.11
unnamed: J2.3, J3.29
unnamed: J2.4, J3.12
unnamed: J2.5, J3.30
unnamed: J2.6, J3.13
unnamed: J2.7, J3.31
unnamed: J2.8, J3.14
unnamed: J2.9, J3.32
unnamed: J2.10, J3.15
unnamed: J2.11, J3.33
unnamed: J2.12, J3.16
unnamed: J2.13, J3.34
unnamed: J2.14, J3.17
unnamed: J2.15, J3.35
unnamed: J2.16, J3.18
unnamed: J2.17, J3.36
unnamed: J2.18, J3.19
unnamed: J2.19, J2.20, J3.37

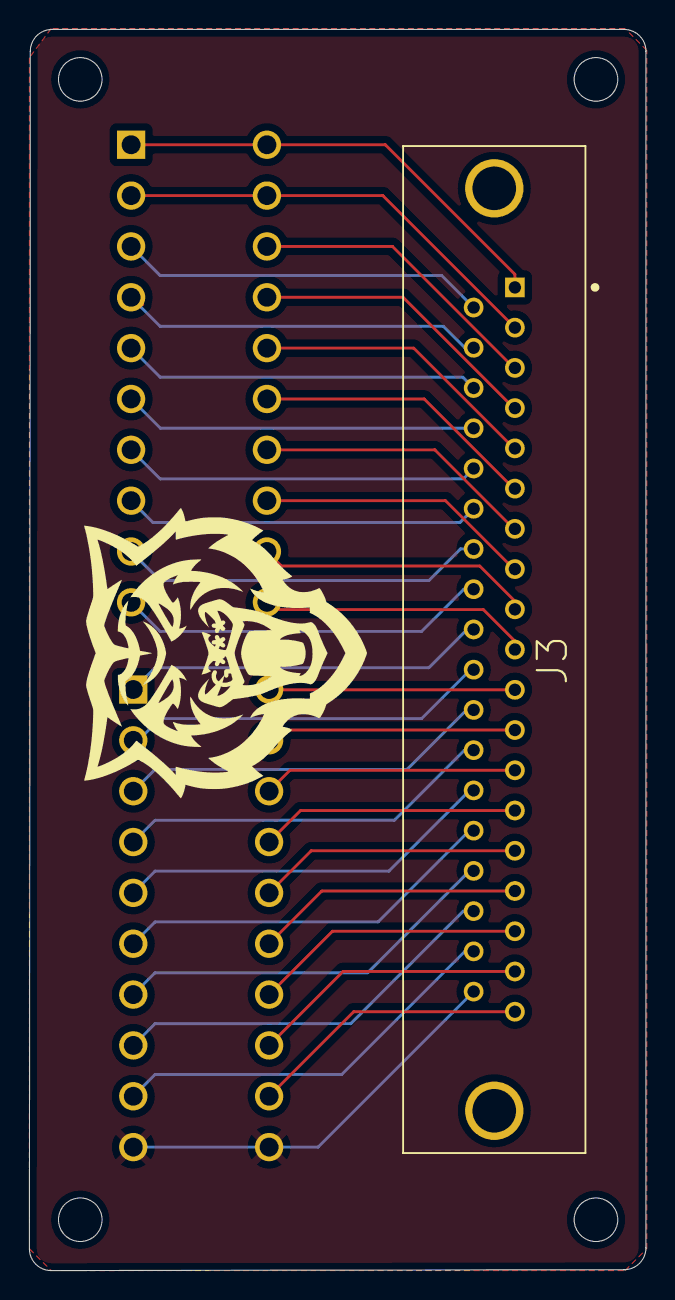
[picture p78: board IF Box PCB.kicad_pcb from above]

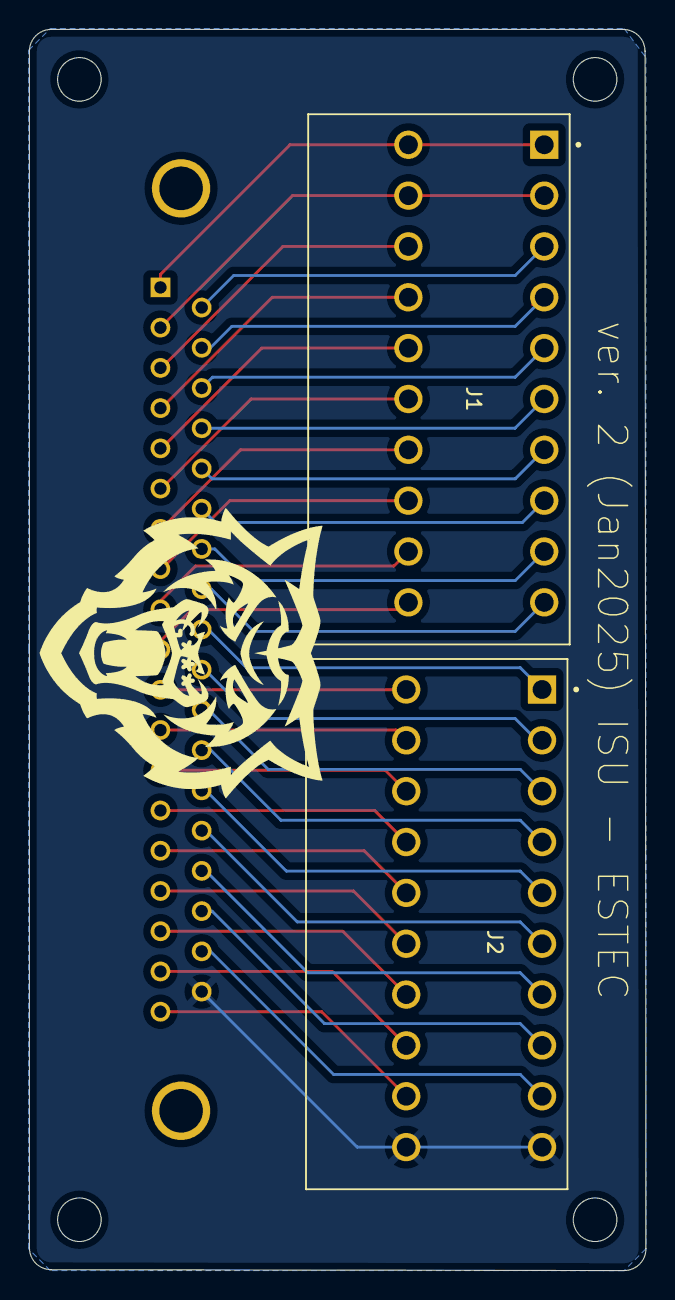
[picture p79: board IF Box PCB.kicad_pcb from below]

Board: 2 copper layers, 42.4 x 85.4 mm, 3 parts (2 on the bottom side), 37 nets.
