rosstimo/MotorProject/PCB/MotorInterfacePiPico/MotorInterfacePiPico.kicad_pcb

## KiCad design PCB/MotorInterfacePiPico/MotorInterfacePiPico.kicad_pcb (2024-07-03)

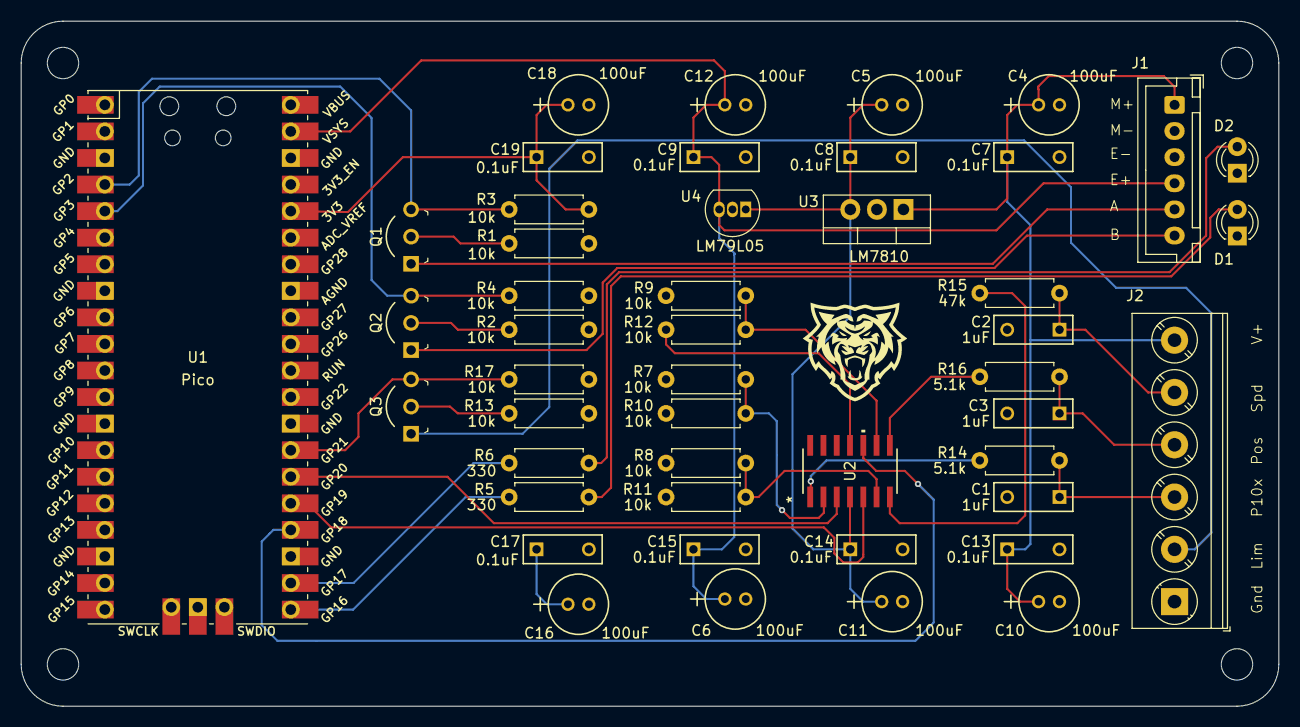
[picture p80: board MotorInterfacePiPico.kicad_pcb from above]

Board: 2 copper layers, 120.2 x 65.5 mm, 47 parts (0 on the bottom side), 30 nets.

Parts:
C1, C2, C3: 1uF; C_Rect_L7.3mm_W4.5_H9.5mm_P5.0mmx
C4, C5, C6, C10, C11, C12, C16, C18: 100uF; C_Radial_D5.00mm_H12.5mm_P2.00mm
C7, C8, C9, C13, C14, C15, C17, C19: 0.1uF; C_Rect_L7.3mm_W2.5_H6.5mm_P5.0mm
D1, D2: LED; LED_D3.0mm
J1: Motor Connector; JST_XH_B6B-XH-A_1x06_P2.50mm_Vertical
J2: Screw_Terminal_01x06; TerminalBlock_Phoenix_PT-1,5-6-5.0-H_1x06_P5.00mm_Horizontal
Q1, Q2, Q3: 2N3904; TO-92-3_Formed_Leads
R1, R2, R3, R4, R7, R8, R9, R10, R11, R12, R13, R17: 10k; R_Axial_DIN0207_L6.3mm_D2.5mm_P7.62mm_Horizontal
R5, R6: 330; R_Axial_DIN0207_L6.3mm_D2.5mm_P7.62mm_Horizontal
R14, R16: 5.1k; R_Axial_DIN0207_L6.3mm_D2.5mm_P7.62mm_Horizontal
R15: 47k; R_Axial_DIN0207_L6.3mm_D2.5mm_P7.62mm_Horizontal
U1: Pico; RPi_Pico_SMD_TH
U2: OPA4197; D14_TEX
U3: LM7810; TO-220-3_Vertical
U4: LM79L05; TO-92_Inline

Connections:
+3.3V: C16.1, C17.1, C18.1, C19.1, R1.1, R2.1, R3.1, R4.1, R7.1, R8.1, R9.1, R13.1, R17.1, U1.36 (3V3)
+5V: C6.1, C9.1, C12.1, C15.1, J1.4, U1.39 (VSYS), U4.3 (VI)
+10V: C5.1, C8.1, C11.1, C14.1, U2.4 (V+), U3.3 (VO), U4.1 (VO)
+12V: C4.1, C7.1, C10.1, C13.1, J1.1, J2.6, U3.1 (VI)
A: J1.5, Q1.1 (E)
Analog Position: C3.1, J2.4, R16.2
Analog Position x10: C1.1, J2.3, R14.2
Analog Speed: C2.1, J2.5, R15.2
B: J1.6, Q2.1 (E)
GND: C1.2, C2.2, C3.2, C4.2, C5.2, C6.2, C7.2, C8.2, C9.2, C10.2, C11.2, C12.2, C13.2, C14.2, C15.2, C16.2, C17.2, C18.2, C19.2, D1.1 (K), D2.1 (K), J1.2, J1.3, J2.1, R10.2, R11.2, R12.2, U1.8 (GND), U1.12 (GPIO9), U1.18 (GND), U1.23 (GND), U1.38 (GND), U2.11 (V-), U3.2 (GND), U4.2 (GND)
Limit Switch: Q3.3 (C), R17.2, U1.27 (GPIO21)
unnamed: D1.2 (A), R5.2
unnamed: D2.2 (A), R6.2
unnamed: J2.2, Q3.1 (E)
unnamed: Q1.2 (B), R1.2
unnamed: Q1.3 (C), R3.2, U1.4 (GPIO2)
unnamed: Q2.2 (B), R2.2
unnamed: Q2.3 (C), R4.2, U1.5 (GPIO3)
unnamed: Q3.2 (B), R13.2
unnamed: R14.1, U2.1
unnamed: R15.1, U2.7
unnamed: R16.1, U2.8
unnamed: R5.1, U1.21 (GPIO16)
unnamed: R6.1, U1.22 (GPIO17)
unnamed: R7.2, R10.1, U2.2 (-)
unnamed: R8.2, R11.1, U2.6 (-)
unnamed: R9.2, R12.1, U2.9 (-)
PWM Position: U1.24 (GPIO18), U2.10 (+)
PWM Position x10: U1.26 (GPIO20), U2.3 (+)
PWM Speed: U1.25 (GPIO19), U2.5 (+)
