rosstimo/MotorProject/(commit log)

2024-04-30 Motor Drawing, Overview, and Specifications
2024-05-03 SVG Files for Motor Mount
2024-05-03 wheel for RPM measurements
2024-05-06 19mm center hole, 15mm length
2024-05-06 TS25GA370H Motor Mount for Testing
    [Body1.3mf, KeyPad.3mf]
2024-05-09 migrate Hbridge
    [Body1.3mf, KeyPad.3mf]
2024-05-10 add TTL Motor Encoder Schem
    [MotorInterface.kicad_pcb, MotorInterface.kicad_sch]
2024-05-10 Initial CircuitPython code for testing Encoder
2024-05-12 update schema
    [MotorInterface.kicad_sch]
2024-05-12 update 7476 symbol
    [MotorInterface.kicad_sch]
2024-05-12 split schema into sheets
    [connectors.kicad_sch, direction.kicad_sch, position.kicad_sch, power.kicad_sch, speed.kicad_sch]
2024-05-13 moved SVG files to Mechanical
    [Body1.3mf, KeyPad.3mf]
2024-05-13 Motor Specifications and Initial Test Data
2024-05-19 Updated Software README and added the Pico C code folder
2024-05-21 Create **Needs added** TS-25GA370H-20 specs
    Details to be added to the motor spec section
2024-05-21 Create **Needs added** Pico encoder documentation
2024-05-22 Update **Needs added** Pico encoder documentation
2024-05-22 H_Bridge Schematic
2024-05-22 Rename **Needs added** Pico encoder documentation to --Needs added-- Pico encoder documentation
    Invalid file name
2024-05-23 cleanup and rename
    [MotorInterface.kicad_pcb, MotorInterface.kicad_sch, connectors.kicad_sch, direction.kicad_sch, position.kicad_sch, power.kicad_sch, speed.kicad_sch]
2024-05-23 update schema notes
    [MotorInterface.kicad_sch]
2024-05-23 update symbols, add decouple
    [MotorInterface.kicad_sch, power.kicad_sch]
2024-05-23 Added Pico Documentation and updated TS Specs
2024-05-23 Pico Encoder Documentation and TS specifications update and compiled single document H-Bridge Motor Control Circuit
2024-05-25 added DB37 to Terminals PCB gerber zip
2024-05-29 Motor Coupler Drawing
2024-05-29 MotorCoupler 3MF file
    [MotorCoupler.3mf]
2024-05-29 added holes
    [MotorCoupler.3mf]
2024-06-06 add tested analog speed circuit
    [MotorInterface.kicad_sch, connectors.kicad_sch, power.kicad_sch]
2024-06-18 start pico PCB
    [MotorInterfacePiPico.kicad_pcb, MotorInterfacePiPico.kicad_sch]
2024-06-19 schema nearly finished
    [MotorInterfacePiPico.kicad_sch]
2024-06-24 clean up PICO schema
    [MotorInterfacePiPico.kicad_sch, power.kicad_sch]
2024-07-01 TL494 Gerber Files
    [H_Bridge-B_Cu.gbl, H_Bridge-B_Mask.gbs, H_Bridge-B_Paste.gbp, H_Bridge-B_Silkscreen.gbo, H_Bridge-Edge_Cuts.gm1, H_Bridge-F_Cu.gtl, H_Bridge-F_Mask.gts, H_Bridge-F_Paste.gtp]
2024-07-01 Layout complete, need silkscreen and BOM
    [MotorInterfacePiPico.kicad_pcb, MotorInterfacePiPico.kicad_sch, power.kicad_sch]
2024-07-01 Delete PCB/MotorInterfacePiPico/MotorInterfacePiPico.pdf
    delete old schema
2024-07-01 New Version of DB37 Terminal adapter PCB
2024-07-03 PCB layout complete, need to DNC, need BOM
    [MotorInterfacePiPico.kicad_pcb]
2024-07-03 Layout complete, need BOM
    [MotorInterfacePiPico.kicad_pcb, MotorInterfacePiPico.kicad_sch, power.kicad_sch]
2024-07-03 add gerbers, need BOM
    [MotorInterfacePiPico-B_Cu.gbl, MotorInterfacePiPico-B_Mask.gbs, MotorInterfacePiPico-B_Paste.gbp, MotorInterfacePiPico-B_Silkscreen.gbo, MotorInterfacePiPico-Edge_Cuts.gm1, MotorInterfacePiPico-F_Cu.gtl, MotorInterfacePiPico-F_Mask.gts, MotorInterfacePiPico-F_Paste.gtp]
2024-07-24 Stop Light and Traffic Intersection 3MF
    [Stop_Light.3mf, Traffic_Intersection.3mf, Traffic_Intersection2.3mf]
2025-02-06 renamed DB37 to Terminals v0.zip Added DB37 to Terminals v2.zip Parts list from DigiKey order
    [MotorController Part list 2024-05-24.xlsx]
2025-05-12 Added DB37 passthrough project folder
    [IF Box PCB-B_Cu.gbl, IF Box PCB-B_Mask.gbs, IF Box PCB-B_Silkscreen.gbo, IF Box PCB-Edge_Cuts.gm1, IF Box PCB-F_Cu.gtl, IF Box PCB-F_Mask.gts, IF Box PCB-F_Silkscreen.gto, IF Box PCB-NPTH.drl]
2025-05-12 don't ignore BOM.csv
2025-05-12 old BOM
    [BOM.csv]
2025-05-13 BOM with digikey links for order
    [BOM.csv]
2025-05-14 Rev2 PCB TL494 with Hbridge
2025-05-14 V2 Schematic
2025-05-29 update pcb
2025-05-30 Surface Mount Board design
    [H_Bridge.kicad_sch, MotorInterfacePiPico.kicad_pcb, MotorInterfacePiPico.kicad_sch, power.kicad_sch]
2025-06-02 Made new Anderson PCB project and reverted Tim R's folder
    [H_Bridge.kicad_sch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]
2025-06-02 Anderson Schematic with opto-couples prior to change to zener diodes
    [H_Bridge.kicad_sch, Pico_H-bridge_complete.kicad_sch]
2025-06-04 Changed Dig inputs to zener buffers, removed all opto-couples, rebuilt h-bridge logic.
    [H_Bridge.kicad_sch, Pico_H-bridge_complete.kicad_sch, power.kicad_sch]
2025-06-05 Anderson PCB ready for board layout
    [H_Bridge.kicad_sch, Pico_H-bridge_complete.kicad_pcb, Pico_H-bridge_complete.kicad_sch]
2025-06-09 Anderson Pico_H-bridge_complete Gerbers ready to order
    [H_Bridge.kicad_sch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]
2025-06-21 minor edits prior to ordering, and assembly document creation
    [H_Bridge.kicad_sch, Pico_H-bridge_complete.kicad_pcb, Pico_H-bridge_complete.kicad_sch]
2025-06-23 Updated Anderson Schematic to fix V0 issues
    [H_Bridge.kicad_sch, Pico_H-bridge_complete.kicad_sch]
2025-07-01 Final Board version prior to testing motor with pulleys. This version would not turn the motor when connected to a generator. The Vgs values for Mosfets needed increased to 10v. Other improvements to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
    [H_Bridge.kicad_sch, Pico_H-bridge_complete.kicad_pcb, Pico_H-bridge_complete.kicad_sch]
2025-07-01 (R's still mostly 0603)H-bridge circuit updated to achieve 10v Vgs. Replaced S0/S1 logic with Fwd/Rev simplified logic. Added header footprint for testing alternative capacitors. Minimized test point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
    [H_Bridge.kicad_sch, Pico_H-bridge_complete.kicad_sch]
2025-07-10 Gerber files for Pico_H-bridge_complete v1 generated
    [H_Bridge.kicad_sch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]
2025-07-14 house keeping
    [Center.3mf, Lane.3mf, StopLight.3mf, StopLight3.3mf, StopLightMountingHolesAdjusted.3mf, Stop_Light.3mf, Traffic_Intersection.3mf, Traffic_Intersection2.3mf]
2025-07-14 StopLight 3D Print Files
    [Center.3mf, Lane.3mf, StopLightMountingHolesAdjusted.3mf]
2025-07-30 Anderson Motor Interface Board v2 complete and ordered.
    [H_Bridge.kicad_sch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]
2025-11-21 Anderson Motor Interface Board v3. - Bengal eyes LED for both directions - heatsink pads on back of board - DIN rail mount Added Heater Box Schematic files in Documentation
    [H_Bridge.kicad_sch, IF Add on Box.kicad_pcb, IF Add on Box.kicad_sch, IF Box PCB.kicad_sch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]
2026-04-19 Update KiCad PCB designs, add LaTeX paper and Gerber v3 test files
    - H-bridge PCB: move footprint lines from Dwgs.User/F.CrtYd to F.Fab, update drill file and Gerber zip
    - DB37 passthrough: add BOM field columns
    - H-bridge project: update BOM export path and plot output dir
    - Add LaTeX research paper source files and images
    - Add Gerber_v3_test production output
    - Add CLAUDE.md project instructions
    - Update .gitignore for LaTeX build artifacts and .claude/ config
    [Pico_H-bridge_complete-B_Courtyard.gbr, Pico_H-bridge_complete-B_Cu.gbl, Pico_H-bridge_complete-B_Fab.gbr, Pico_H-bridge_complete-B_Mask.gbs, Pico_H-bridge_complete-B_Paste.gbp, Pico_H-bridge_complete-B_Silkscreen.gbo, Pico_H-bridge_complete-Edge_Cuts.gm1, Pico_H-bridge_complete-F_Courtyard.gbr]
2026-04-19 Add Pico Setup and Programming Guide, clean up old encoder files
    - Add beginner-friendly PicoSetupGuide LaTeX section with CLI explanations
    - Update .gitignore for Pico-Quad-Encoder cloned repo
    - Remove old Software/quadrature_encoder files (now in cloned repo)
    - Remove Software/test.py and .template submodule
2026-04-20 Reorganize LaTeX paper: final design in main body, development in appendix
    - Add Motor Specifications summary with characterization results
    - Add Schematic Description with Current Design screenshots (v3 board)
    - Move detailed test data, H-bridge dev, TL494 dev to appendices
    - Add Bill of Materials table in appendix with part descriptions
    - Add Current Design schematic images and BOM CSV
    - Correct J1 terminal pinout and document input protection design choices
2026-04-23 Add per-module heater box schematics and update LaTeX figures
    Split the single heater box schematic into four sub-sheets (Din, Dout,
    Ain, Aout) in KiCad and replace the overview figure in the LaTeX paper
    with individual figures for each I/O module with descriptive captions.
    [Ain.kicad_sch, Aout.kicad_sch, Din.kicad_sch, Dout.kicad_sch, IF Add on Box.kicad_sch]
2026-04-25 Add cover page, expand intro, add system concept diagrams
    - New title page with ISU logo and orange-rule banner; document now flows
    cover -> TOC -> Project Overview -> Parts
    - Rewritten Project Overview with Introduction, Learning Progression, and
    Document Roadmap subsections
    - Three concept diagrams in Lab Box concept diagrams.drawio (overall,
    heater box, motor box) plus exported PNGs referenced from the LaTeX
    - Renamed Part I to "System Interfaces"
    - Bold "Figure N:" labels via captionsetup
    - HeaterBoxComponents component-detail refinements
2026-04-28 Add box BOMs and reconcile heater I/O assignments
    Reorganized the BOM appendix into common-box, heater-specific,
    motor-specific, and PCB subsections sourced from the new CSV
    references. Reconciled the digital output table to the actual 3-LED
    front panel and corrected pin assignments. Anchored the PLC I/O
    tables with [H] so 5.4 stops floating to its own page.
2026-04-29 Add fan relay and motor connector cables to BOM
    Adds the Hongfa HF41F/24-ZS slim signal relay (fan relay) to the Heater
    Box BOM, and the JST XH 6-pin (gearmotor) and 4-pin (RS-775 encoder)
    cable assemblies to the Motor Box BOM under a new Motor Cabling
    subsection.
2026-05-02 Clarify Pico setup: check build tools and cp working directory
